anuragbhandari-eng/Gripper_V2/docs/offset_pad_sets_concept_v4.png

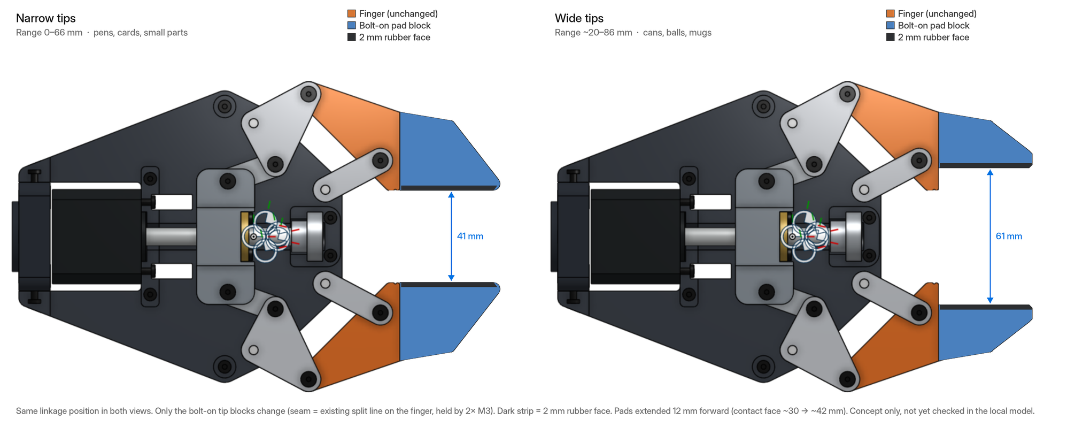
docs/offset_pad_sets_concept_v4.png
