anuragbhandari-eng/Gripper_V2/gripper_fabrication_rev7/BOM.csv

ID | Item | Qty | Note
PRINT | Base x1 (ABS) | 1 | bottom face on bed; 4 walls, 30% gyroid; orientation flat; 107.17 cm3
PRINT | Cover x1 (ABS) | 1 | flat top face on bed; orientation flip_x; 90.33 cm3
PRINT | Adapter ISO9409-50 x1 (ABS) | 1 | gripper-side face on bed, spigot up; orientation front_down; 37.95 cm3
PRINT | Carriage x1 (ABS) | 1 | rear face on bed, nut recess up; no supports; 100% infill around inserts and nut-screw pilots; orientation rear_down; 20.16 cm3
PRINT | BellCrank Lower U x1 (ABS) | 1 | spacer boss up; orientation flat; 5.52 cm3
PRINT | BellCrank Lower L x1 (ABS) | 1 | mirror of BellCrank Lower U (other side); orientation flat; 5.52 cm3
PRINT | BellCrank Upper U+L x2 (ABS) | 2 | same part both sides (flip one); orientation flat; 3.07 cm3
PRINT | FrontCrank Lower U+L x2 (ABS) | 2 | spacer boss up; orientation flat; 2.78 cm3
PRINT | FrontCrank Upper U+L x2 (ABS) | 2 | ; orientation flat; 1.43 cm3
PRINT | ConRod U+L x2 (ABS) | 2 | ; orientation flat; 2.41 cm3
PRINT | Finger U x1 (ABS) | 1 | tongue forward; M layer only since rev 7; orientation flat; 10.19 cm3
PRINT | Finger L x1 (ABS) | 1 | mirror of Finger U; orientation flat; 10.19 cm3
PRINT | Fit test gripper x1 (ABS) | 1 | print FIRST (rev 7 fits): tongue stub + tip-block pocket stub (install the 2 inserts, then test the slide fit and the M3x10 screws), AS5600 slot (1.6 mm board), M6 nut pocket, 2020 column socket, magnet puck (try it in a 608); not part of the gripper; orientation flat; 23.47 cm3
PRINT | Fit test pad x1 (TPU) | 1 | print FIRST in TPU 95A: pad stub with the snap barb, for the pocket stub groove (it should snap in and not pull out by hand); orientation face_down; 0.71 cm3
PRINT | Tip block U narrow x1 (ABS) | 1 | narrow set; floor down, tongue pocket opens upward; orientation flat; 16.1 cm3
PRINT | Tip block L narrow x1 (ABS) | 1 | mirror of Tip block U narrow; orientation flat; 16.1 cm3
PRINT | Tip block U wide x1 (ABS) | 1 | wide set; floor down, tongue pocket opens upward; orientation flat; 10.13 cm3
PRINT | Tip block L wide x1 (ABS) | 1 | mirror of Tip block U wide; orientation flat; 10.13 cm3
PRINT | Pad TPU U+L x4 (TPU) | 4 | TPU 95A, contact face on bed; 2 per tip set (same pad fits both); orientation side_py_down; 1.71 cm3
PRINT | Encoder magnet puck x1 (ABS) | 1 | magnet pocket up; glue to the screw end; orientation rear_down; 0.07 cm3
PRINT | Stand head bracket x1 (ABS) | 1 | bench stand; back face on bed, nut pockets and column hole open upward; orientation rear_down; 137.36 cm3
PRINT | Stand base x1 (ABS) | 1 | bench stand; table face on bed, column socket up; orientation front_down; 257.41 cm3
PRINT | Stand desk clamp U x1 (ABS) | 1 | desk clamp; lying on its side, nut slot up, 100% infill at the corners; orientation side_my_down; 52.58 cm3
PRINT | Stand desk clamp L x1 (ABS) | 1 | mirror of Stand desk clamp U; orientation side_py_down; 52.58 cm3
PRINT | Stand clamp pad U+L x2 (TPU) | 2 | desk side down; felt on it is optional; orientation rear_down; 2.54 cm3
PRINT | Controller spacer rear+front U+L x4 (ABS) | 4 | end on bed, 100% infill; 4 mm tall, replaces the brass standoffs (M3 x 10 through board and spacer into the cover insert); orientation flat; 0.06 cm3
PRINT | Electronics cover x1 (ABS) | 1 | top face on bed, no supports; 2 M3 x 8 into the cover-top inserts; orientation flip_x; 16.62 cm3
PRINT | Fit test coupons x1 (ABS) | 1 | Print FIRST: checks pin bores, z-stack gaps, 608 seat and carriage tongue fit on your printer; 16 cm3
P1 | NEMA 17 stepper with integrated Tr8x8 lead screw (4 start, 8 mm lead) and brass flange nut: YEJMKJ N17-Y42-39-SG240, body 42 x 42 x 38.7 mm, 240 mm screw, 0.44 N.m, 1.7 A, 2.2 ohm, 3.1 mH, rotor about 65 g.cm2 (Amazon US ASIN B0FHHWXJLV, in the cart) | 1 | Cut the screw so it sticks out 71.0 mm past the D22 pilot face (73.0 mm from the mounting face), -0.5/+0: never long, the encoder puck fills the last 3 mm of the 608 bore; chamfer the end. The body is 1.3 mm shorter than modelled (40 mm), so the gap to the adapter is 2.3 mm: no change needed. If the flange nut is missing, buy a Tr8x8 brass flange nut (22 mm flange, 4 holes)
P2 | Tr8x8 brass flange nut (flange D22 x 3.5, body D10.2, 4x D3.5 on D16; check on the listing) - usually supplied with P1 | 1
P3 | 608ZZ ball bearing 8 x 22 x 7 | 1 | Screw tip support; carries the grip thrust into the block front lip
P12 | Shaft lock collar, 8 mm bore, OD <= 14 mm, width <= 7 mm, with set screw (e.g. OpenBuilds T8 lock collar) | 1 | Behind the 608, against its inner ring: takes the screw reaction when gripping
P4 | Dowel pin D4 x 40, hardened bearing steel, +/-0.02 mm, cut to 38.5 mm (Amazon US has no hardened 4 x 36) | 4 | Fixed pivots O1, O2: cut each pin to 38.5 mm with an abrasive cut-off disc (deburr the cut end), press it up through the base from underneath until flush with the underside; its top then sits flush with the cover top (9 mm of press fit)
P27 | Sintered bronze sleeve bushing 4 x 6 x 6 mm + slow-cure epoxy + paste wax | 4 | Bonded into the cover round the dowel tops (rev 7.1)
P28 | Locating pin D3 x 16: an M3 x 16 button screw from the kit with the head cut off (cost cut; replaces an ISO 8734 3 x 16 dowel) | 2 | Register the base and cover halves of the bearing block: screw into the base half, cover half slides on
P5 | Shoulder screw, 4 mm shoulder x 12 mm, M3 thread <= 6 mm, head <= D7.5 x 3.5 (bought: MECCANIXITY 304 stainless, M3 x 6 thread, head D7 x 3) | 8 | Moving pivots F1, F2, D, C x2 sides
P6 | M3 heat-set insert, M3 x 5.7, for D4.0 hole | 28 | Buy 30 (rev 7: +4 in the finger tongues, +4 in the cover top for the controller; rev 7.2: +2 for the electronics cover)
P7 | M3 x 8 button head screw ISO 7380 | 14 | 4 motor (3.5 mm into the motor), 2 cover-to-post, 2 nut flange (self-tap into D2.5 pilots), 4 side walls to adapter, 2 electronics cover
P8 | M3 x 20 button head screw ISO 7380 | 4 | Cover to motor wall (2) and bearing block (2)
P13 | M3 x 10 button head screw ISO 7380 | 8 | Tip blocks to the finger tongues, from below (2 per side); controller board through its spacers into the cover inserts (4)
P9 | M6 x 12 socket head cap screw ISO 4762 (6 mm into the robot flange; check its thread depth) | 4 | Adapter to ISO 9409-1-50-4-M6 flange
P10 | Grease: PTFE/lithium for lead screw and pivots (ask the fablab; any light grease works) | 1
P11 | TMC2209 stepper driver module, StepStick size (e.g. BIGTREETECH TMC2209), UART + DIAG | 1 | Current limit 0.70 A RMS (section 4); plugged into female headers on the protoboard so it can be swapped
P14 | Raspberry Pi Pico (or Pico H with headers) | 1 | USB serial to ROS 2; on the protoboard
P15 | AS5600 magnetic encoder module (about 23 x 23 mm) + 6 x 2.5 mm diametric magnet | 1 | Solder 4 wires (VCC, GND, SDA, SCL) to the pad row, no header; pad row up
P16 | Double-sided protoboard 50 x 70 mm, cut to 48 x 60 mm | 1 | Score and snap (or saw) it to 48 x 60, then drill 4 corner holes to 3.2 mm on a 42 x 54 mm pattern
P17 | Printed spacer Controller spacer rear+front U+L x4 (D5.5 x 4, room for the solder joints under the board) + M3 x 10 button screw from the kit | 4 | Screw through the board and spacer into the cover-top insert
P18 | L7805 5 V regulator + 1N5817 Schottky diode (any 1 A diode works) + 2 x 100 nF (ask the fablab first) | 1 | 9 V line -> 7805 -> diode -> Pico VSYS: one cable from the power bank runs everything, the laptop is optional and can be plugged in at the same time
P19 | USB-C PD power bank, about 10,000 mAh, 20 W, any brand that says PD (all of them offer 9 V); use one you already own | 1 | Battery and charger in one: recharge it from any USB charger. Sits on the desk next to the stand (the modelled pack on the column is a placeholder)
P20 | USB-C PD trigger (decoy) board, set to 9 V; check its output with a multimeter before connecting the driver | 1 | USB-C cable from the power bank, or from any USB-C laptop or phone charger of 18 W or more; + and - go to TMC2209 VM, the divider and the 7805
P21 | Not needed with the power bank: LiPo, balance charger, XT30 pigtail, fuse holder (the bank has its own protection) | 0
P22 | Resistors 100 k + 27 k (battery divider into Pico ADC0; 22 k also works, change the ratio in firmware) + 10 k (EN pull-up), 100 uF 35 V capacitor at TMC2209 VM; 100 nF at ADC0 optional (ask the fablab first) | 1
P23 | 2020 aluminium extrusion, 400 mm (V-slot or T-slot) | 1 | Bench stand column
P24 | M5 T-nut for 2020 (sliding or drop-in) + M5 x 12 screw, 4 + 1 for the column end; 4 bench screws not needed with the desk clamps | 1 | Head bracket to column (2), base socket to column (2), base to column end (1: tap the end M5, 4 mm of thread is enough, or skip it). Sliding T-nuts go in from the column ends before the bracket and base
P29 | M8 x 40 star knob screw (male thread) + M8 hex nut (nut from the fablab or a hardware store) | 2 | Desk clamps (nut drops into the slot in each clamp)
P30 | Self-adhesive felt pads, about 25 mm (optional, not bought) | 4 | On the clamp pads and under the base front corners, to protect the desk
P25 | M6 x 20 socket head cap screw ISO 4762 + M6 hex nut | 4 | Adapter to the stand head bracket (nuts drop into the bracket from the back)
P26 | TPU 95A filament | 1 | Contact pads (Pad TPU U+L x4, 4 pcs)
