anuragbhandari-eng/Gripper_V2/ros2_ws/src/lead_screw_gripper_description/onshape/assets/merged/finger_L_link_visual.stl

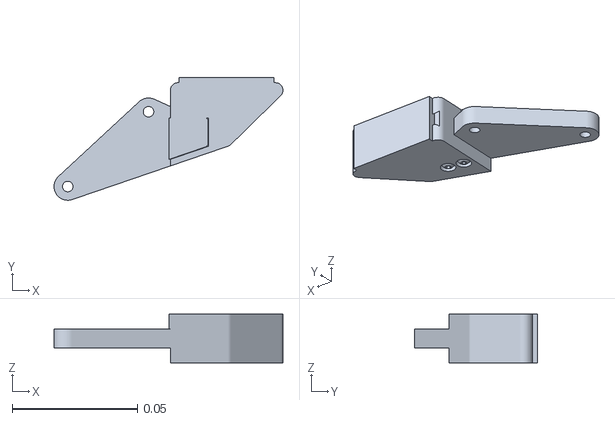
[picture p7: CAD file, 2026-11-13]
ros2_ws/src/lead_screw_gripper_description/onshape/assets/merged/finger_L_link_visual.stl
0.0915 x 0.049 x 0.0195
