anuragbhandari-eng/Gripper_V2/ros2_ws/src/lead_screw_gripper_description/onshape_render/assets/pico_ref_board_step__none.stl

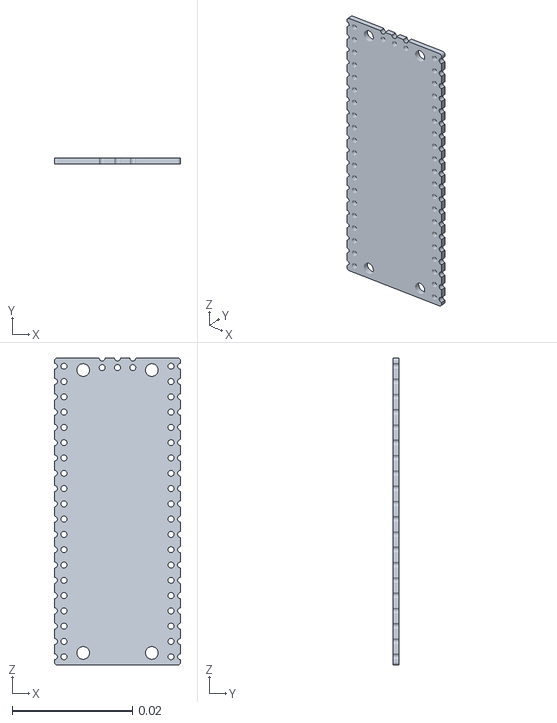
[picture p8: CAD file, 2026-11-13]
ros2_ws/src/lead_screw_gripper_description/onshape_render/assets/pico_ref_board_step__none.stl
0.021 x 0.001 x 0.051
