anuragbhandari-eng/Gripper_V2/ros2_ws/src/lead_screw_gripper_description/meshes/visual/base.stl

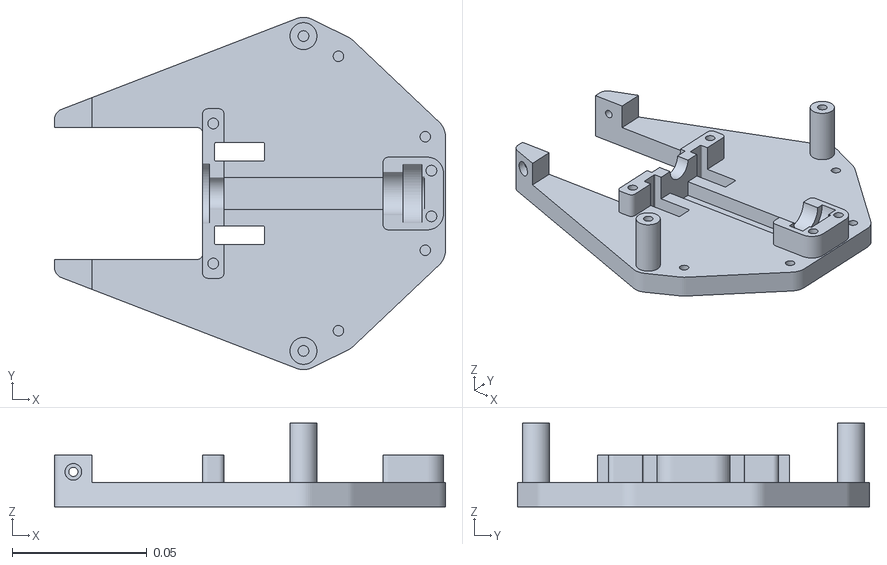
[picture p9: CAD file, 2026-11-13]
ros2_ws/src/lead_screw_gripper_description/meshes/visual/base.stl
0.145 x 0.131 x 0.0311
