anuragbhandari-eng/Gripper_V2/ros2_ws/src/lead_screw_gripper_description/onshape/assets/merged/conrod_U_link_visual.stl

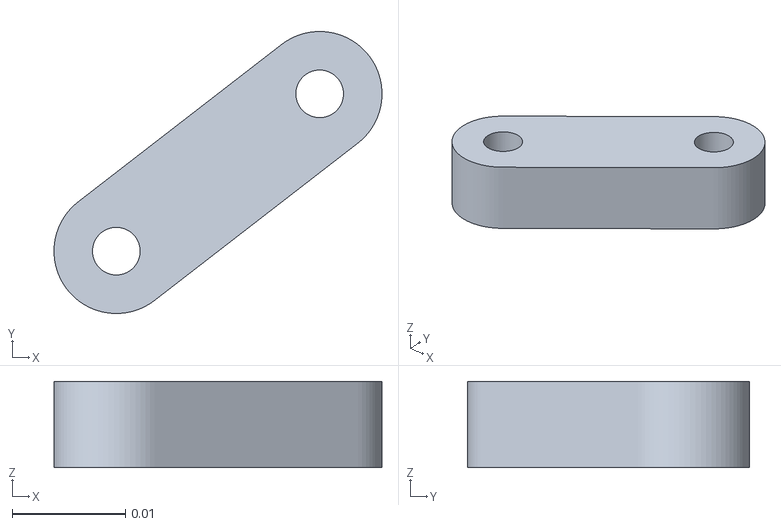
[picture p10: CAD file, 2026-11-13]
ros2_ws/src/lead_screw_gripper_description/onshape/assets/merged/conrod_U_link_visual.stl
0.0289 x 0.0249 x 0.0076
