anuragbhandari-eng/Gripper_V2/ros2_ws/src/lead_screw_gripper_description/onshape_render/assets/cover.stl

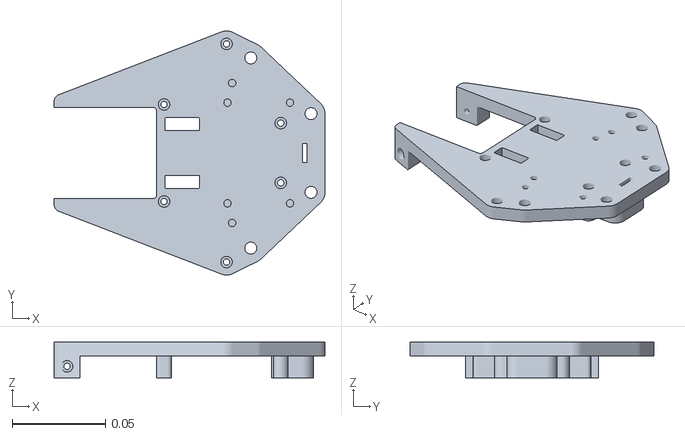
[picture p11: CAD file, 2026-11-13]
ros2_ws/src/lead_screw_gripper_description/onshape_render/assets/cover.stl
0.145 x 0.131 x 0.0192
