anuragbhandari-eng/Gripper_V2/ros2_ws/src/lead_screw_gripper_description/meshes/visual/bell_crank_upper_u.stl

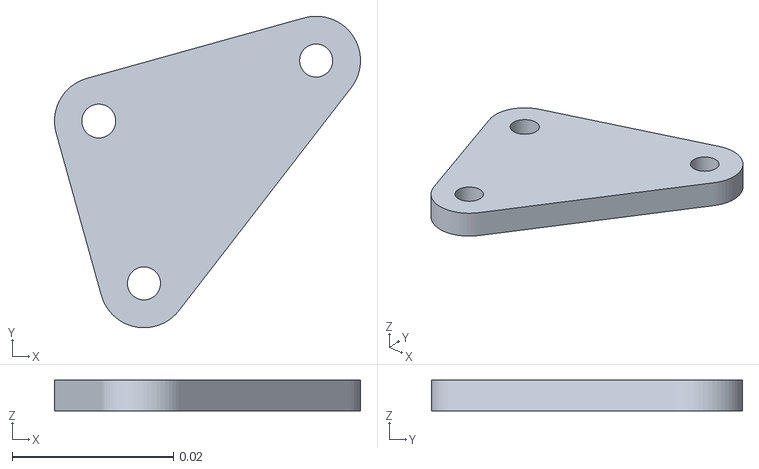
[picture p12: CAD file, 2026-11-13]
ros2_ws/src/lead_screw_gripper_description/meshes/visual/bell_crank_upper_u.stl
0.038 x 0.0386 x 0.0038
