anuragbhandari-eng/Gripper_V2/ros2_ws/src/lead_screw_gripper_description/onshape_render/assets/socket_button_head_screw_m3x0_5_x_20__a36a91f17289e228f9f9bd0e86f10504.stl

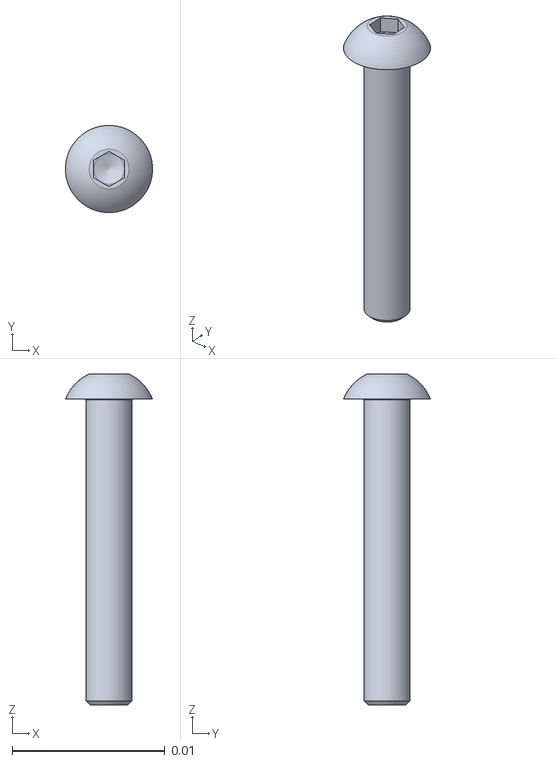
[picture p13: CAD file, 2026-11-13]
ros2_ws/src/lead_screw_gripper_description/onshape_render/assets/socket_button_head_screw_m3x0_5_x_20__a36a91f17289e228f9f9bd0e86f10504.stl
0.0057 x 0.0057 x 0.0216
