anuragbhandari-eng/Gripper_V2/ros2_ws/src/lead_screw_gripper_description/onshape/assets/merged/carriage_link_visual.stl

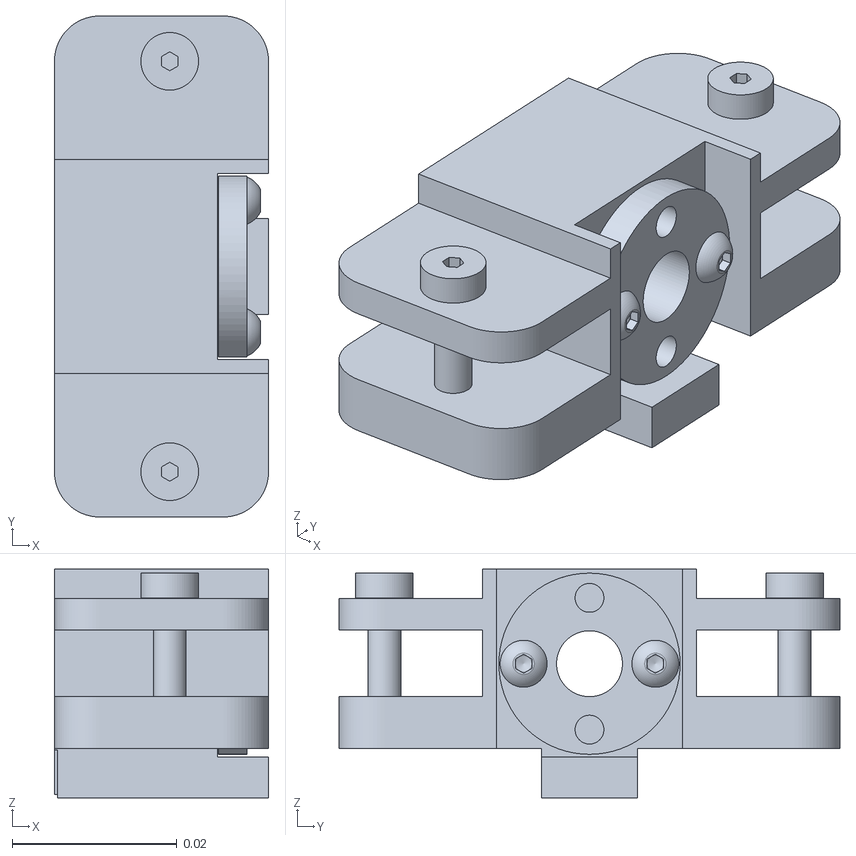
[picture p14: CAD file, 2026-11-13]
ros2_ws/src/lead_screw_gripper_description/onshape/assets/merged/carriage_link_visual.stl
0.026 x 0.0608 x 0.0278
