anuragbhandari-eng/Gripper_V2/ros2_ws/src/lead_screw_gripper_description/onshape_render/assets/bushing_4x6x6_o1_l.stl

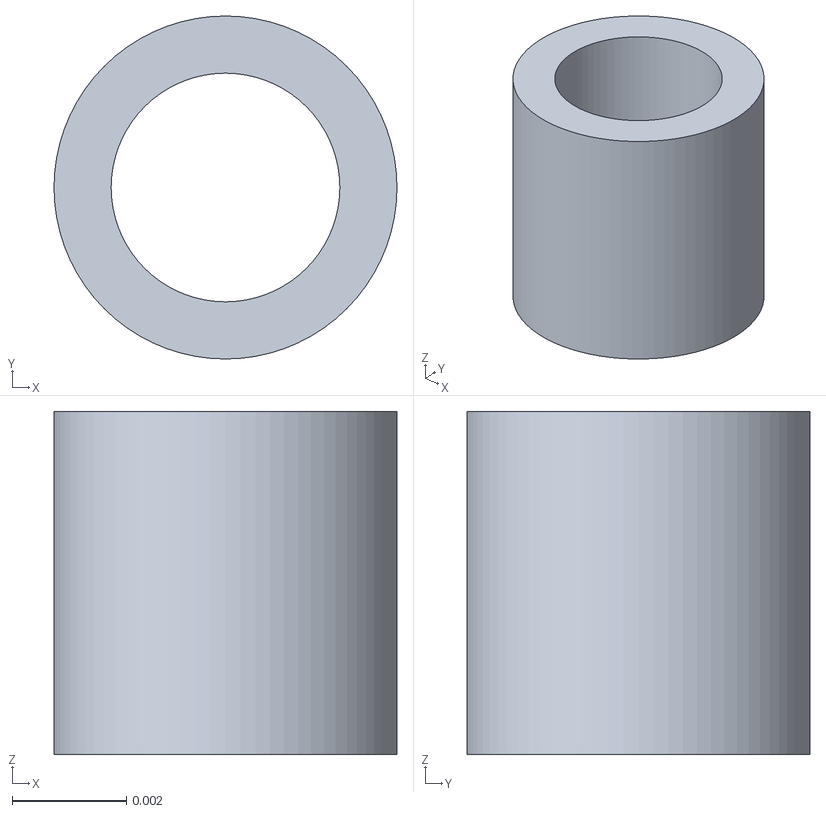
[picture p15: CAD file, 2026-11-13]
ros2_ws/src/lead_screw_gripper_description/onshape_render/assets/bushing_4x6x6_o1_l.stl
0.006 x 0.006 x 0.006
