anuragbhandari-eng/Gripper_V2/ros2_ws/src/lead_screw_gripper_description/onshape/assets/merged/bell_crank_U_link_visual.stl

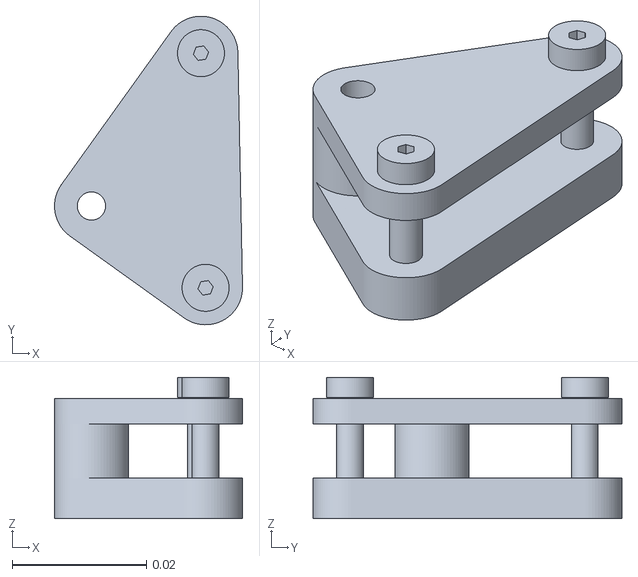
[picture p16: CAD file, 2026-11-13]
ros2_ws/src/lead_screw_gripper_description/onshape/assets/merged/bell_crank_U_link_visual.stl
0.028 x 0.0459 x 0.021
