anuragbhandari-eng/Gripper_V2/ros2_ws/src/lead_screw_gripper_description/onshape_render/assets/pico_bourns_step__none.stl

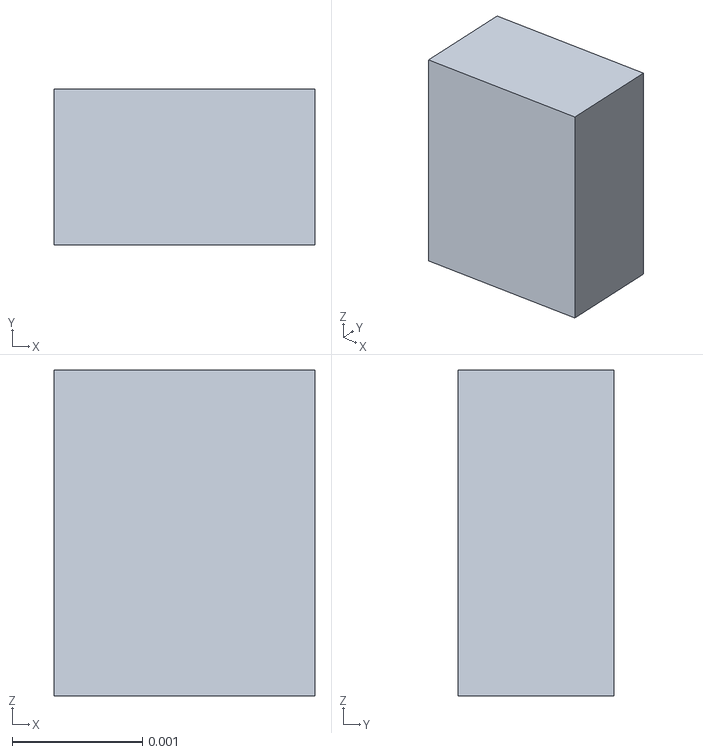
[picture p17: CAD file, 2026-11-13]
ros2_ws/src/lead_screw_gripper_description/onshape_render/assets/pico_bourns_step__none.stl
0.002 x 0.0012 x 0.0025
