anuragbhandari-eng/Gripper_V2/ros2_ws/src/lead_screw_gripper_description/onshape/assets/merged/front_crank_L_link_visual.stl

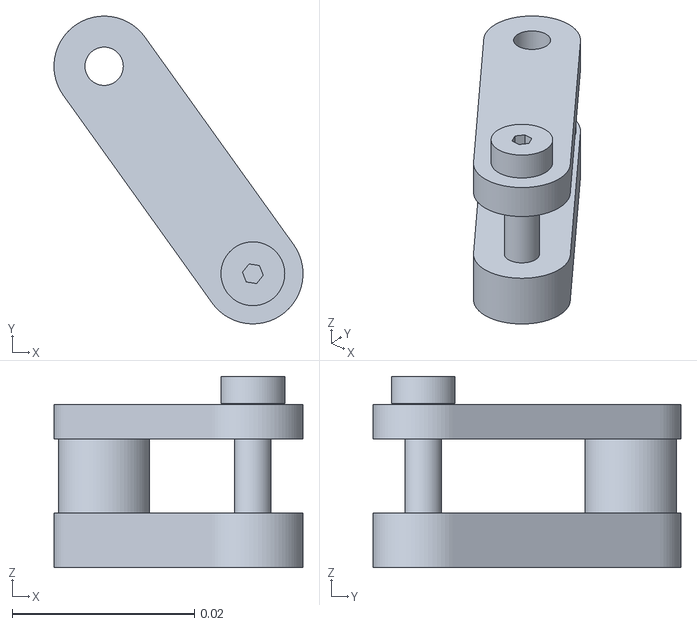
[picture p18: CAD file, 2026-11-13]
ros2_ws/src/lead_screw_gripper_description/onshape/assets/merged/front_crank_L_link_visual.stl
0.0273 x 0.0338 x 0.021
