anuragbhandari-eng/Gripper_V2/ros2_ws/src/lead_screw_gripper_description/onshape_render/assets/locating_pin_m3x16_headless_u.stl

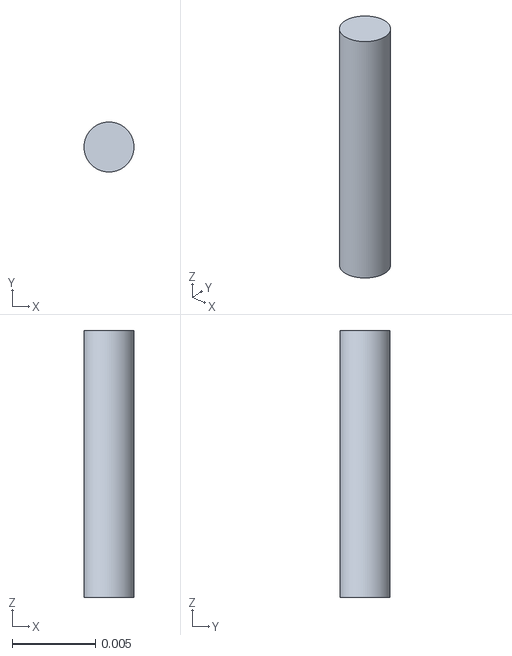
[picture p19: CAD file, 2026-11-13]
ros2_ws/src/lead_screw_gripper_description/onshape_render/assets/locating_pin_m3x16_headless_u.stl
0.003 x 0.003 x 0.016
