anuragbhandari-eng/Gripper_V2/ros2_ws/src/lead_screw_gripper_description/onshape_render/assets/controller_spacer_front_l.stl

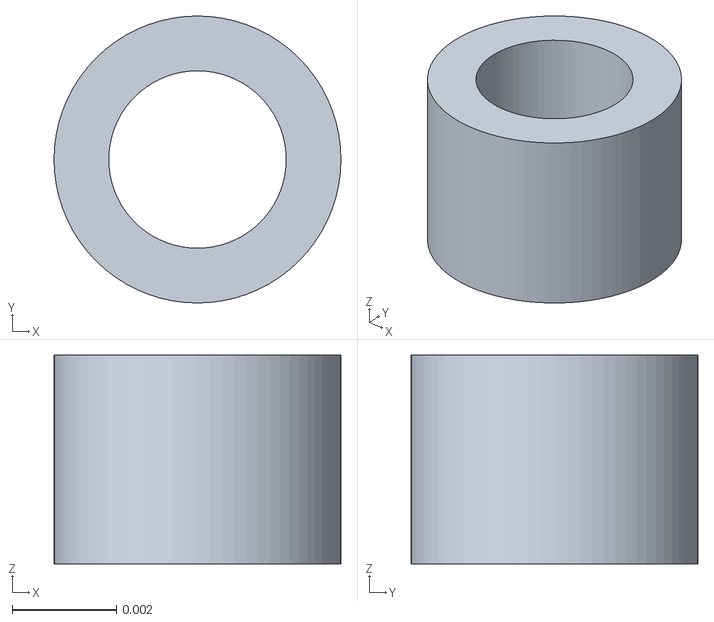
[picture p20: CAD file, 2026-11-13]
ros2_ws/src/lead_screw_gripper_description/onshape_render/assets/controller_spacer_front_l.stl
0.0055 x 0.0055 x 0.004
