anuragbhandari-eng/Gripper_V2/(list of files, cad)

Other CAD files:
ros2_ws/src/lead_screw_gripper_description/onshape/assets/merged/conrod_L_link_visual.stl
ros2_ws/src/lead_screw_gripper_description/onshape/assets/merged/front_crank_U_link_visual.stl
ros2_ws/src/lead_screw_gripper_description/onshape/assets/merged/finger_U_link_visual.stl
ros2_ws/src/lead_screw_gripper_description/onshape/assets/merged/base_link_visual.stl
ros2_ws/src/lead_screw_gripper_description/onshape/assets/merged/bell_crank_L_link_visual.stl
ros2_ws/src/lead_screw_gripper_description/onshape_render/assets/608zz_bearing.stl
ros2_ws/src/lead_screw_gripper_description/onshape_render/assets/adapter_iso9409_50.stl
ros2_ws/src/lead_screw_gripper_description/onshape_render/assets/as5600_encoder_board.stl
ros2_ws/src/lead_screw_gripper_description/onshape_render/assets/base.stl
ros2_ws/src/lead_screw_gripper_description/onshape_render/assets/bellcrank_lower_l.stl
ros2_ws/src/lead_screw_gripper_description/onshape_render/assets/bellcrank_lower_u.stl
ros2_ws/src/lead_screw_gripper_description/onshape_render/assets/bellcrank_upper_l.stl
ros2_ws/src/lead_screw_gripper_description/onshape_render/assets/bellcrank_upper_u.stl
ros2_ws/src/lead_screw_gripper_description/onshape_render/assets/bushing_4x6x6_o1_u.stl
ros2_ws/src/lead_screw_gripper_description/onshape_render/assets/bushing_4x6x6_o2_l.stl
ros2_ws/src/lead_screw_gripper_description/onshape_render/assets/bushing_4x6x6_o2_u.stl
ros2_ws/src/lead_screw_gripper_description/onshape_render/assets/capacitor_100uf_35v.stl
ros2_ws/src/lead_screw_gripper_description/onshape_render/assets/carriage.stl
ros2_ws/src/lead_screw_gripper_description/onshape_render/assets/conrod_l.stl
ros2_ws/src/lead_screw_gripper_description/onshape_render/assets/conrod_u.stl
ros2_ws/src/lead_screw_gripper_description/onshape_render/assets/controller_spacer_front_u.stl
ros2_ws/src/lead_screw_gripper_description/onshape_render/assets/controller_spacer_rear_l.stl
ros2_ws/src/lead_screw_gripper_description/onshape_render/assets/controller_spacer_rear_u.stl
ros2_ws/src/lead_screw_gripper_description/onshape_render/assets/dowel_4x38_5__40_cut__o1_l.stl
ros2_ws/src/lead_screw_gripper_description/onshape_render/assets/dowel_4x38_5__40_cut__o1_u.stl
ros2_ws/src/lead_screw_gripper_description/onshape_render/assets/dowel_4x38_5__40_cut__o2_l.stl
ros2_ws/src/lead_screw_gripper_description/onshape_render/assets/dowel_4x38_5__40_cut__o2_u.stl
ros2_ws/src/lead_screw_gripper_description/onshape_render/assets/electronics_cover.stl
ros2_ws/src/lead_screw_gripper_description/onshape_render/assets/encoder_magnet_puck.stl
ros2_ws/src/lead_screw_gripper_description/onshape_render/assets/finger_l.stl
ros2_ws/src/lead_screw_gripper_description/onshape_render/assets/finger_u.stl
ros2_ws/src/lead_screw_gripper_description/onshape_render/assets/frontcrank_lower_l.stl
ros2_ws/src/lead_screw_gripper_description/onshape_render/assets/frontcrank_lower_u.stl
ros2_ws/src/lead_screw_gripper_description/onshape_render/assets/frontcrank_upper_l.stl
ros2_ws/src/lead_screw_gripper_description/onshape_render/assets/frontcrank_upper_u.stl
ros2_ws/src/lead_screw_gripper_description/onshape_render/assets/header_sockets_driver_2x8.stl
ros2_ws/src/lead_screw_gripper_description/onshape_render/assets/header_sockets_driver_2x8__2.stl
ros2_ws/src/lead_screw_gripper_description/onshape_render/assets/header_sockets_pico_2x20.stl
ros2_ws/src/lead_screw_gripper_description/onshape_render/assets/header_sockets_pico_2x20__2.stl
ros2_ws/src/lead_screw_gripper_description/onshape_render/assets/locating_pin_m3x16_headless_l.stl
ros2_ws/src/lead_screw_gripper_description/onshape_render/assets/lock_collar_8x14x7__thrust.stl
ros2_ws/src/lead_screw_gripper_description/onshape_render/assets/magnet_6x2_5_diametric.stl
ros2_ws/src/lead_screw_gripper_description/onshape_render/assets/nema17_stepper_yejmkj_42x38_7.stl
ros2_ws/src/lead_screw_gripper_description/onshape_render/assets/pad_tpu_l.stl
ros2_ws/src/lead_screw_gripper_description/onshape_render/assets/pad_tpu_u.stl
ros2_ws/src/lead_screw_gripper_description/onshape_render/assets/pico_ael_step__none.stl
ros2_ws/src/lead_screw_gripper_description/onshape_render/assets/pico_diodes_step__none.stl
ros2_ws/src/lead_screw_gripper_description/onshape_render/assets/pico_murata_step__none.stl
ros2_ws/src/lead_screw_gripper_description/onshape_render/assets/pico_murata_step__none_1.stl
ros2_ws/src/lead_screw_gripper_description/onshape_render/assets/pico_ref_led_step__none.stl
ros2_ws/src/lead_screw_gripper_description/onshape_render/assets/pico_ref_microcontroller_step__none.stl
ros2_ws/src/lead_screw_gripper_description/onshape_render/assets/pico_ref_onsemi_step__none.stl
ros2_ws/src/lead_screw_gripper_description/onshape_render/assets/pico_ref_switch_step__none.stl
ros2_ws/src/lead_screw_gripper_description/onshape_render/assets/pico_ref_usb_step__none.stl
ros2_ws/src/lead_screw_gripper_description/onshape_render/assets/pico_ref_usb_step__none__2.stl
ros2_ws/src/lead_screw_gripper_description/onshape_render/assets/pico_ref_usb_step__none__3.stl
ros2_ws/src/lead_screw_gripper_description/onshape_render/assets/pico_ref_usb_step__none__4.stl
ros2_ws/src/lead_screw_gripper_description/onshape_render/assets/pico_ref_usb_step__none__5.stl
ros2_ws/src/lead_screw_gripper_description/onshape_render/assets/pico_richtek_step__none.stl
ros2_ws/src/lead_screw_gripper_description/onshape_render/assets/pico_winbond_step__none.stl
ros2_ws/src/lead_screw_gripper_description/onshape_render/assets/protoboard_50x70.stl
ros2_ws/src/lead_screw_gripper_description/onshape_render/assets/regulator_7805_to_220.stl
ros2_ws/src/lead_screw_gripper_description/onshape_render/assets/shoulder_screw_4x12_m3_c_l.stl
ros2_ws/src/lead_screw_gripper_description/onshape_render/assets/shoulder_screw_4x12_m3_c_u.stl
ros2_ws/src/lead_screw_gripper_description/onshape_render/assets/shoulder_screw_4x12_m3_d_l.stl
ros2_ws/src/lead_screw_gripper_description/onshape_render/assets/shoulder_screw_4x12_m3_d_u.stl
ros2_ws/src/lead_screw_gripper_description/onshape_render/assets/shoulder_screw_4x12_m3_f1_l.stl
ros2_ws/src/lead_screw_gripper_description/onshape_render/assets/shoulder_screw_4x12_m3_f1_u.stl
ros2_ws/src/lead_screw_gripper_description/onshape_render/assets/shoulder_screw_4x12_m3_f2_l.stl
ros2_ws/src/lead_screw_gripper_description/onshape_render/assets/shoulder_screw_4x12_m3_f2_u.stl
ros2_ws/src/lead_screw_gripper_description/onshape_render/assets/socket_button_head_screw_m3x0_5_x_10__ab5dc1006d13f2491c23b78383e7390f.stl
ros2_ws/src/lead_screw_gripper_description/onshape_render/assets/socket_button_head_screw_m3x0_5_x_8__06a2044c27756322d8b45e7715e9afaa.stl
ros2_ws/src/lead_screw_gripper_description/onshape_render/assets/tip_block_l.stl
ros2_ws/src/lead_screw_gripper_description/onshape_render/assets/tip_block_u.stl
ros2_ws/src/lead_screw_gripper_description/onshape_render/assets/tmc2209_driver.stl
ros2_ws/src/lead_screw_gripper_description/onshape_render/assets/tr8_brass_flange_nut.stl
ros2_ws/src/lead_screw_gripper_description/onshape_render/assets/tr8x8_lead_screw__cut_73_0mm.stl
ros2_ws/src/lead_screw_gripper_description/onshape_render/assets/usb_c_pd_trigger_9v.stl
