anuragbhandari-eng/Gripper_V2/docs/BUILD_AND_TEST_GUIDE.html

Gripper V2 build

0 / 0

REV 7.2b · BUILD AND TEST GUIDE

# From a box of parts to a working gripper

Nine parts, A to I. Every step ends with a check, so a problem shows up where it starts. Tick the boxes as you go: this page remembers them on this device.

If a check fails, stop. Note what the Thonny shell printed, or what you see, and find the cause before going on.

blue in a picture = parts added in that step pale = already fitted

The finished gripper: dark base and cover, orange fingers with black grip pads, and the controller under its cover on top.

What you are building. Controller on top, jaws at the front.

## Five safety rules

1. Never plug or unplug the motor or the driver while the power is on. That kills the TMC2209 instantly. Unplug the 9 V and the laptop USB first.
2. The driver current is a safety setting. Set VREF to 0.99 V before the motor is ever connected, and never higher. At full current the motor can push about 259 N, far more than the printed parts are designed for.
3. Use 9 V only. Set the trigger board to 9 V and measure it before it touches the board.
4. Tighten every M3 screw only until snug, with the short arm of the key (0.15 N·m). More than that crushes the ABS.
5. Keep fingers out of the jaws while it's powered. With the driver off the jaws go limp and can be pushed by hand. That is normal: the screw back-drives.

## What you need besides the parts

### Tools

- Soldering iron, with a spare or conical tip for heat-set inserts
- Multimeter and calipers
- Metric hex keys: 2 mm for every M3 screw, 5 mm for M6, 3 or 4 mm for the M5 screws (depends on the kit), plus a 2 mm ball-end
- 4.0 mm drill bit (turned by hand) and a 3.2 mm drill bit
- Dremel with an abrasive cut-off wheel. The dowels are hardened; a hacksaw won't cut them
- Hacksaw for the lead screw, small file
- Bench vise with soft jaws, flush cutters, pliers
- Small plastic or ceramic screwdriver for the driver's pot
- Safety glasses for cutting and pressing steel
- Optional: M5 tap

### Consumables

- Solder, heat-shrink, tape
- Hookup wire: thin (24 AWG) for signals, thicker (20 AWG) for 9 V and the motor
- 30-minute epoxy and CA (super) glue
- Light grease, and a little wax or grease as a release agent
- Zip ties
- 2 M8 hex nuts
- USB-C cable from the laptop to the Pico
- USB-C cable from the power bank to the trigger board
- 20 W USB-C PD power bank

A

## When the parts arrive

A1

### Check the parts

DONE

Measure each part with calipers before anything else. If one is off, update that part in design.py.

Part | It should measure
Motor | Body 42 × 42 mm and at most 40 mm long. Pilot Ø22 × 2. M3 holes on a 31 mm square. Screw usable length at least 73 mm
Brass nut (on the motor screw) | Flange Ø22 × 3.5, body Ø10.2, 4 holes. If it's missing, buy a Tr8x8 flange nut
AS5600 board | At most 23 × 23 mm with the chip centred. Parts on the chip side within a 19.6 mm square
Shoulder screws | Shoulder Ø4 × 12, thread M3 at most 6 mm long, head at most Ø7.5 × 3.5
Dowels | Ø4.0 × 40. A bronze bushing slides onto a dowel with no play
Lock collar | Bore 8 mm, OD at most 14 mm, width at most 7 mm
608ZZ bearing | Spins freely. If not, use another from the pack

Check All parts measured and within size

A2

### Print the fit tests first

DONE

Three small prints check every fit that depends on your printer. Print them in ABS on the printer you'll use for the real parts. They take a few hours and can save a full reprint.

Fit test gripper x1.stl · ABS · fit its 2 inserts first (see D2) The tongue stub slides into the tip-block pocket stub with no play and no forcing The 2 M3×10 screws go in and hold An AS5600 board slides into the slot An M6 nut drops into its pocket The 2020 extrusion fits its socket The magnet fits its puck, and the puck fits inside a 608

Fit test pad x1.stl · TPU It snaps into the pocket-stub groove and doesn't pull out by hand

Fit test coupons x1.stl · ABS A dowel presses into the Ø3.9 hole, is snug in Ø4.1 and turns freely in Ø4.2 The stacked test plates move freely in their 0.2 / 0.3 mm gaps A 608 sits in the cradle against the front lip, no rattle and no forcing The 11.6 mm tongue slides along the 12.0 mm channel

If a fit is off, change that one clearance in the design and re-export the parts before you print them.

A3

### Magnet test

DONE

Do this before printing the base and cover. The magnet sits inside the steel 608, which can weaken its field. This 5-minute test confirms the encoder still reads well there.

1. Install MicroPython on the Pico (step C1).
2. Glue the magnet into the puck from the fit test, and push the puck into a 608.
3. Wire the AS5600 to the Pico: VCC → 3V3 (pin 36), GND → GND (pin 38), SDA → GP0 (pin 1), SCL → GP1 (pin 2), DIR → GND.
4. Hold the board flat in front of the magnet, chip centred on it and about 0.8 mm away. The test only means something in that position.
5. Open as5600_bench_test.py in Thonny, run it, and turn the 608's inner ring slowly by hand.

Check It prints "magnet: OK" the whole time AGC sits roughly between 30 and 100 The angle runs smoothly through 0–360° once per turn

Stop if it says "too weak" or AGC sits at 128. The magnet would then have to move in front of the bearing, which needs a longer block.

B

## Print everything

B1

### Settings and order

DONE

The files are in gripper_fabrication_rev7/stl/. Each file name ends with how many to print (x1, x2, x4). Orientations are in the design report, section 6.

Setting | Value
Material | ABS in an enclosed printer, part fan low or off
Layers and walls | 0.2 mm layers, 4 perimeters
Infill | 30–40% gyroid, 100% around insert holes
Brim and supports | Brim on the base, cover and all stand parts. No supports anywhere

1. Base and cover. The largest, and the most likely to warp.
2. Small parts: carriage, adapter, cranks, conrods and fingers.
3. Both tip sets, the encoder puck, the 4 controller spacers and the electronics cover (top face on the bed).
4. In TPU: the 4 jaw pads and the 2 stand clamp pads.
5. Stand parts: base, head bracket and 2 desk clamps. ABS is preferred; PLA is fine if the big base warps.

Check Flatness: the base, cover and stand base sit on glass without rocking. Reprint any that rock Quantities match the x2 and x4 in the file names

C

## Electronics on the bench

Do this while the parts print.

C1

### Install MicroPython and Thonny

DONE

1. Install Thonny (https://thonny.org) on your laptop.
2. Download the latest MicroPython UF2 for the Raspberry Pi Pico (RP2040) from micropython.org.
3. Hold the Pico's BOOTSEL button while plugging it into the laptop. Drag the UF2 onto the RPI-RP2 drive that appears.
4. In Thonny: Tools → Options → Interpreter → "MicroPython (Raspberry Pi Pico)".
5. Copy bench.py to the Pico: open it in Thonny, then File → Save as → Raspberry Pi Pico → bench.py.

Check Typing import bench in the Thonny shell prints the list of tests. Errors about missing hardware are fine for now

C2

### Solder the controller board

DONE

1. Cut the 50 × 70 mm protoboard down to 48 × 60 mm: score along a row of holes and snap it, or saw it.
2. Drill 4 mounting holes to 3.2 mm, in two rows. Each row is 3 mm in from a short (48 mm) edge, so the rows are 54 mm apart. In each row:
  - one hole is 3 mm from the long edge on the driver side;
  - the other is 36.5 mm from that same edge, on the Pico's centreline between its two socket rows.
3. Cut the 1 × 40 socket strips into two 1 × 20 rows for the Pico and two 1 × 8 rows for the driver. Check which way round the driver goes (EN pin to EN) before soldering its sockets.
4. Lay the parts out as in the picture, so the cover fits:
  - Pico sockets along one long edge, USB end at a short edge.
  - Driver sockets beside the Pico, toward the other short edge.
  - Trigger board taped flat at the USB end next to the Pico, its socket just over the edge.
  - 7805 lying flat beside it, legs bent down 90°, tab 6–7 mm in from the edge and clear of the corner screw.
  - 100 µF capacitor standing between the 7805 and the driver.
5. Wire it to the table below. Keep the 9 V wires short and thick.

The controller board with its Pico, driver, regulator, capacitor and USB-C trigger board, lifted above the gripper's cover with four spacers and screws.

The finished board and where it will sit (fitted in Part E).

From | To | Notes
Trigger board + | 9 V line: driver VM, 7805 IN, 100 k (divider top), 100 µF + | Thick wire
Trigger board − | Common GND | Thick wire
100 µF 35 V | Across VM and GND, right next to the driver | Mind the polarity (stripe = −)
7805 | IN = 9 V, GND, OUT → 1N5817 anode | 100 nF from IN to GND and from OUT to GND. Pins left to right, label facing you: IN, GND, OUT
1N5817 | Cathode (the band) → Pico VSYS (pin 39) | Lets USB and the 9 V be connected together
Divider | 100 k from 9 V to Pico GP26 (pin 31); 27 k from GP26 to GND | 9 V reads 1.91 V. Optional 100 nF across the 27 k
All grounds | Pico GND (pin 38 and others), both driver GND pins, AS5600 GND | Every ground joins the same line
Pico 3V3 (pin 36) | Driver VIO, AS5600 VCC
Pico GP2 (pin 4) | Driver STEP
Pico GP3 (pin 5) | Driver DIR
Pico GP4 (pin 6) | Driver EN | Plus 10 k from EN to 3V3: keeps the driver off while the Pico starts
Pico GP8 (pin 11) | 1 k resistor → driver UART/PDN pin
Pico GP9 (pin 12) | Driver UART/PDN pin, directly | Same pin as the 1 k
Pico GP5 (pin 7) | Driver DIAG | Optional (stall backup)
Pico GP0 (pin 1), GP1 (pin 2) | AS5600 SDA, SCL | 4-wire lead; also AS5600 DIR → GND
Driver coil pins | Motor coils (step C6) | Marked 1A/1B/2A/2B or A1/A2/B1/B2

Use the labels printed on your driver board. Leave MS1 and MS2 unconnected; that sets UART address 0.

Check Board soldered and every row of the table checked against it

C3

### Power check, boards out

DONE

1. Set the trigger board to 9 V (a button on some boards, a solder jumper on others). Plug it into the power bank and measure 9.0 V ± 0.3 at its output before it touches the board.
2. Connect it to the board with neither the Pico nor the driver plugged in, and measure the four points below.
3. Unplug the power.

Check with the multimeter 9 V between the driver socket's VM and GND 5.0 V at the 7805 OUT 4.6–5.0 V between Pico socket pins 39 (VSYS) and 38 (GND). With nothing plugged in it reads close to 5.0 About 1.9 V between pin 31 (GP26) and GND Nothing gets warm

From here on, "unplug the power" means both the 9 V and the laptop USB cable, whenever a board or cable goes in or out.

C4

### Pico in: test 1

DONE

Plug the Pico into its socket, driver still out. Connect the laptop, then the 9 V. In the Thonny shell:

import bench bench.t1_power()

Check It prints about 9 V and "OK". With the 9 V unplugged it prints "none"

C5

### Driver in: set the current, then test 3

DONE

1. Unplug the power. Plug the driver into its socket. The motor stays disconnected.
2. Plug in the 9 V. Measure between the small pot on the driver and GND, and turn the pot with a plastic or ceramic screwdriver until it reads 0.99 V. That sets a 0.70 A ceiling on the BTT TMC2209 V1.3. On a different driver board, work out its VREF for 0.70 A from its sense resistor first.
3. In Thonny, run the test.

bench.t3_driver()

Check VREF reads 0.99 V It prints "version 0x21" and "Settings taken … 1/16"

C6

### Make the motor cable

DONE

The motor has 4 wires in 2 coil pairs. Find the pairs with the multimeter on ohms: wires of the same pair read about 2.2 Ω, wires from different pairs read open.

- One pair goes to the driver's first coil pins (1A/1B), the other to the second (2A/2B).
- If the motor later turns the wrong way, the software fixes it in test F4. There's no need to swap wires.

Don't connect the motor to the board yet.

Check Coil pairs found and the cable made

D

## Mechanical assembly

The order matters. Step D10 uses epoxy and needs a night to cure.

D1

### Clean up the prints

DONE

Don't drill the Ø3.9 dowel press holes in the base. The cover's dowel holes are oversize on purpose.

Check A 4.0 mm drill turned by hand passes through every pivot bore in the cranks, conrods, fingers and carriage Brims and strings removed, and the carriage tongue slides along the base channel

D2

### Heat-set inserts: 28 in all

DONE

Set the iron to about 230 °C. Rest the insert on its hole and let it sink under its own weight plus light pressure, until it's flush with the face it goes in from. Keep it straight.

Part | Inserts | Where
BellCrank Lower U and L | 2 each | F1 and D
FrontCrank Lower ×2 | 1 each | F2
Carriage | 2 | Lower ears. Press from underneath (the upper ear is in the way from above) until level with the lower ear's upper face. A shoulder screw should seat on it
Fingers ×2 | 2 each | In the underside of the tongue
Base | 6 | 2 at the motor-wall joint, 2 at the bearing-block ears, 2 posts
Adapter | 4 | Side holes
Cover top | 6 | 4 for the controller board, 2 for the electronics cover

Check 28 inserts in, all flush and straight

D3

### Locating pins and dowels

DONE

1. Locating pins: screw two M3×16 screws into the bearing-block half of the base until 8 mm of thread is in. Then cut the heads off and deburr the ends.
2. Dowels: cut each 4 × 40 dowel to 38.5 mm with the abrasive cut-off disc. Deburr the cut end.
3. Press them up through the base from underneath at O1 and O2 on both sides, square to the plate, until flush with the underside. Use the vise with soft jaws, and put a tube or drilled block over the dowel on the top side: about 29.5 mm comes out there.
4. Smear wax or grease on the top 8 mm of each dowel, so the epoxy in D10 doesn't stick to it.

Don't fit the bronze bushings yet. The cranks have to go over the dowels first. The bushings go on in D10.

Check 2 pins and 4 dowels in, dowels flush underneath and square

The base plate with four dowels entering from below, two short locating pins above the bearing block and four bronze bushings floating above the dowel positions.

Dowels come up from below. The bushings shown above them wait until D10.

D4

### Prepare the lead screw

DONE

1. Collar pull test: tighten the lock collar's set screw on the end of the screw and pull hard by hand. It must not slip. Then take it off.
2. Cut the screw to 73.0 mm from the motor's mounting face (71.0 mm past the round pilot), tolerance −0.5 / +0. Never long: the encoder puck fills the last 3 mm.
3. File a small chamfer on the cut end, clean off the chips and grease the thread.

Check Collar held in the pull test Screw cut to length (measured twice) and greased

D5

### Nut, carriage, collar and bearing onto the screw

DONE

1. Slide the brass nut into the carriage from the front: body into the bore, flange into the front recess, holes at 3 and 9 o'clock. Fit 2× M3×8, snug only.
2. Spin the carriage onto the screw.
3. Slide on the lock collar with its set screw loose, then the 608.

Check Order on the screw from the motor: carriage with nut, collar, 608

The motor and lead screw with the carriage on the screw, then the lock collar and the 608 bearing shown spaced out along the axis.

Carriage, then collar, then bearing.

D6

### Drive into the base

DONE

1. Lay it all into the base with the motor connector facing up:
  - the pilot goes in the wall recess;
  - the carriage tongue goes in the channel;
  - the 608 sits in its cradle against the front lip, collar behind it.
2. Fit the 2 lower motor screws (M3×8) through the access slots with the 2 mm ball-end.
3. Push the collar forward until it just touches the 608 inner ring, with no preload, and tighten its set screw.
4. Turn the motor shaft by hand. The carriage must run end to end without binding. Then tighten the 2 nut screws.

Check The carriage runs the full length smoothly by hand

The motor, lead screw, carriage, collar and bearing as one unit being lowered into the base plate.

The whole drive lowers in as one unit.

D7

### Encoder

DONE

1. Glue the magnet into the puck, flush. Push the puck into the 608 bore against the screw end and fix it there with a drop of CA.
2. Solder 4 wires (VCC, GND, SDA, SCL) to the AS5600 pad row, plus a short link from DIR to GND.
3. Drop the board into the slot in front of the 608, chip toward the magnet and pads up.

Check Board fully down in its slot, chip side facing the magnet, 4 wires pointing up

The small encoder board dropping into a slot in front of the bearing, with the magnet puck going into the bearing bore.

Puck into the bearing, board into the slot in front of it.

D8

### Linkage, both sides

DONE

Parts marked U and L are mirror images, one for each side. If a part doesn't sit flat with its boss up, it belongs on the other side.

1. BellCrank Lower on O1 and FrontCrank Lower on O2, bosses up.
2. Finger onto F1 and F2. Conrod onto D, and between the carriage ears at C.
3. BellCrank Upper and FrontCrank Upper on top.
4. Shoulder screws at F1, F2, D and C, into the inserts. Snug only.

Check Pushing one finger moves both jaws together, smoothly, over the full range

Four lower crank plates dropping onto the four dowels.

1. Lower plates onto the dowels.

The two fingers and two connecting rods being placed on the lower crank plates.

2. Fingers and conrods.

The upper crank plates going on top, with eight shoulder screws above them.

3 and 4. Upper plates, then 8 shoulder screws.

D9

### Tip blocks and pads

DONE

Fit the narrow set first.

1. Slide a TPU pad into a tip block's groove from the rear and press until its barb snaps past the step. A drop of soapy water helps.
2. Push the tip block up onto the finger tongue from below, and fit 2× M3×10 from below.

Check Both tip blocks on with 2 screws each, pads snapped in and facing each other

The gripper seen from underneath, with the two tip blocks and their screws going up onto the finger tongues.

Seen from underneath: blocks and screws go on from below.

D10

### Cover and bushings, then wait overnight

DONE

1. Thread the encoder wires up through the slit in the cover as you lower it, and check the motor connector is free.
2. Put a little epoxy into the 4 oversize dowel holes in the cover, and lower the cover over the dowels.
3. Push a bronze bushing down over each dowel top into its hole, until the bushing's top is about 1.4 mm below the cover top. Wipe any epoxy off the dowel tops.
4. Fit the cover screws: 2× M3×20 at the motor wall, 2× M3×20 at the bearing-block ears, 2× M3×8 at the posts, then the 2 upper motor screws (M3×8) through the cover slots.
5. Let it cure fully, overnight, with everything assembled. The bushings bond exactly where the dowels are.

A bushing must not rest on the crank underneath. Look again after 10 minutes and lift any that has slid down.

Check the next day, power off The jaws push open and closed by hand over the full range: smooth, no clicks, no rubbing

Once the controller is on, two cover screws sit under its board. To take the cover off later, remove the controller first.

The dark cover plate being lowered onto the assembled gripper, with eight screws above it.

Cover down, bushings in, 8 screws.

E

## Controller onto the gripper

E1

### Mount the board and its cover

DONE

1. Unplug the Pico and the driver from their sockets. Put the 4 printed spacers (4 mm) on the cover-top inserts, set the board on them, and fit 4× M3×10 through the board and spacers. Then plug the Pico and driver back in.
2. Power off: connect the motor cable to the driver and the AS5600 lead to the board.
3. Zip-tie each cable (USB, power, motor, encoder) to the board as strain relief.
4. Lower the electronics cover over the board with the cables in its notches:
  - both USB-C cables through the two notches in the short wall at the USB end;
  - motor cable at the motor end;
  - encoder wires at the jaw end.
5. Fit 2× M3×8 through its flanges. Do this before plugging in the Pico's USB cable: the plug sits over one of the screws.

Check Board held by 4 screws, all 4 cables tied down Cover on with 2 screws, no cable pinched, and the BOOTSEL button reachable through the window in its top

The electronics cover with its vents and window being lowered over the controller board on top of the gripper.

The cover goes on last, held by 2 screws.

F

## First powered tests

Set the gripper on the bench, or clamp it in its stand first (Part G). Plug in the laptop, then the 9 V. Run the tests in order.

F1–F6

### Six tests, in order

DONE

import bench # once per session

Run each command, tick when it passes bench.t1_power() prints about 9 V and "OK" bench.t2_encoder() while you push the jaws by hand: "magnet OK", and the angle and turns change as the jaws move bench.t3_driver() prints "version 0x21" and the settings taken bench.t4_direction(): follow the prompts with the jaws half open. It moves 2 mm and you answer y/n. Ends with "Saved: dir_close=…, enc_sign=…" bench.t5_tracking() with the jaws about half open (it moves 4 mm each way): both moves "OK" bench.t6_home() prints "Homed" and the pads then open to 30 mm, within 1 mm on the calipers

"Homed" alone is not a pass. If the encoder isn't counting, it says "Homed" straight away without closing. The 30 mm caliper reading is the real test.

F7

### Try the gripper

DONE

bench.goto(40) # open to 40 mm bench.grip() # put an object between the pads first bench.goto(40) # release

Check Grip test: it grips an object of about 500 g that is 30–55 mm wide (a slim bottle, or a small jar with coins in it). When you let go, the object hangs without slipping, even when shaken gently Wide tips: run bench.off(), swap to the wide tip blocks (2 screws each side), then bench.tips('wide'), bench.home() and bench.goto(60). The pads are 60 mm apart

A standard 500 ml bottle is about 65 mm wide, too wide for the narrow tips. Test it with the wide tips and bench.goto(75).

G

## Bench stand and desk clamps

G1

### Build the stand

DONE

1. Slide the T-nuts into the column's slots first: 2 near the bottom for the base socket and 2 for the head bracket.
2. Push the column into the base socket and fit 2× M5×12 through the socket walls into the T-nuts. Optional: M5×12 from below into the column end, if you tapped it M5.
3. Drop an M8 nut into the slot of each desk clamp and thread a star knob in from below. Seat a TPU clamp pad on the knob's screw tip, socket side down.
4. Put the base on the desk with its front edge flush with the desk's front edge. Hook a clamp over each front corner (its boss drops into the corner counterbore) and tighten the knobs by hand.
5. Slide the head bracket onto the column and lock it with 2× M5×12 into its T-nuts. Drop 4 M6 nuts into the bracket pockets from the back.
6. Bolt the adapter to the bracket with 4× M6×20. Slide the gripper onto the adapter (the U-slot is open at the rear) and fit 4× M3×8 through the side walls.

Always clamp it. The stand tips over if it isn't clamped to the desk.

Check The stand doesn't move when you push the gripper sideways

The gripper hanging jaws-down from a head bracket on an aluminium column, on a printed base plate held to the desk edge by two clamps.

Jaws down, base clamped to the desk edge.

H

## Demo mode and taking it with you

H1

### Stand-alone demo, no laptop

DONE

Save main.py on the Pico next to bench.py. From then on, plugging the USB-C cable into a power bank makes the gripper home itself and open. Each press of the Pico's BOOTSEL button then grips or releases. To stop the demo, connect Thonny, or delete main.py from the Pico.

Check On power bank only: it homes, opens, and grips and releases on each button press

A power bank that switches itself off: some banks turn off when little current is drawn. The driver's hold current normally keeps the bank awake. If yours still switches off, press its button, or use another bank or a wall charger.

H2

### Portable kit

DONE

Pack Gripper on its stand, or the stand in pieces 2 desk clamps (they fit edges 24–49 mm thick) Power bank, charged, and its USB-C cable Backup power: any USB-C laptop or phone charger of 18 W or more also gives 9 V A few objects to grip, and the wide tips with 4 M3×10 screws and a 2 mm key Laptop and USB cable, if you want to show ROS 2 control

I

## Troubleshooting

What you see | Likely cause | Fix
t1_power reads 0 V with power plugged in | Trigger board not at 9 V, or a divider wiring error | Measure the trigger output; check the 100 k / 27 k to GP26
t1_power reads 5 V | The trigger board fell back to 5 V: the bank or charger isn't PD, or the trigger isn't set | Use a PD source; set the trigger to 9 V
"AS5600 not found" | Wiring | VCC to 3V3, SDA to GP0, SCL to GP1, DIR to GND; check solder joints
"magnet too weak / not detected" | Board not centred on the magnet, or too far away | Board fully down in its slot, chip side toward the magnet
t3_driver: "No reply" | UART wiring or no 9 V | 1 k from GP8 to the UART pin, GP9 straight to the same pin; 9 V present; driver the right way round
Motor buzzes but doesn't turn | A coil pair is split across the two driver outputs | Redo C6 with the power off: each pair on its own output
Motor turns, encoder doesn't count | Encoder cable or magnet | t2_encoder() while turning the jaws by hand
t5_tracking off by a lot | Steps lost: binding in the mechanism, or the current too low | Power off and check the hand movement; check VREF is 0.99 V
Says "Homed" at once but the jaws didn't close, or the F6 gap is wrong | Encoder not counting, or its direction saved wrongly | t2_encoder(), then t4_direction() again
"Homing failed (…)" | The jaws never stopped within 40 mm, or a power or driver fault | Read the reason in the brackets; run t5_tracking()
Jaws open by themselves when the power is off | Normal: the screw back-drives | Keep the power on to hold a grip
Driver very hot | VREF set too high | Set VREF to 0.99 V. Warm is normal; too hot to touch is not
Gripper slips on objects | Low current at large gaps, or a dry screw | Grease the screw; note the gap and the object, and check CURRENT_TABLE

Progress is saved in this browser only. Clear all ticks
