anuragbhandari-eng/Gripper_V2/gripper_fabrication_rev7/images/build_guide_rev7/d8a_lower.webp

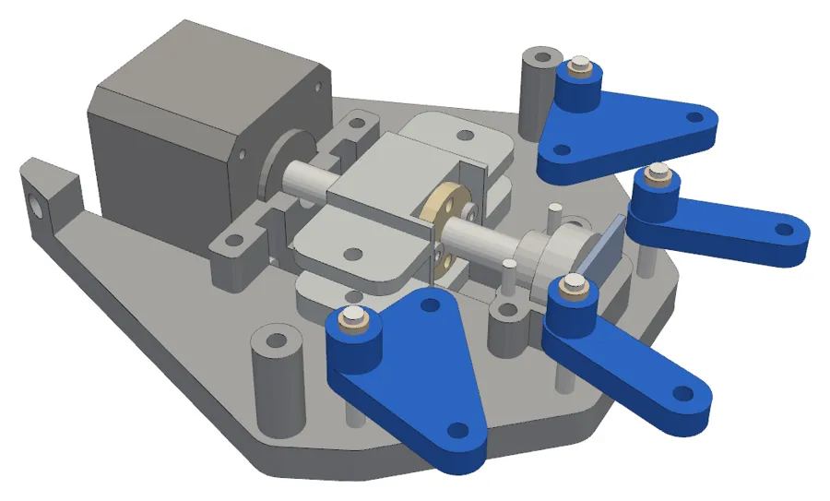
gripper_fabrication_rev7/images/build_guide_rev7/d8a_lower.webp
