anuragbhandari-eng/Gripper_V2/gripper_fabrication_rev7/images/onshape_v2_assembly_front.png

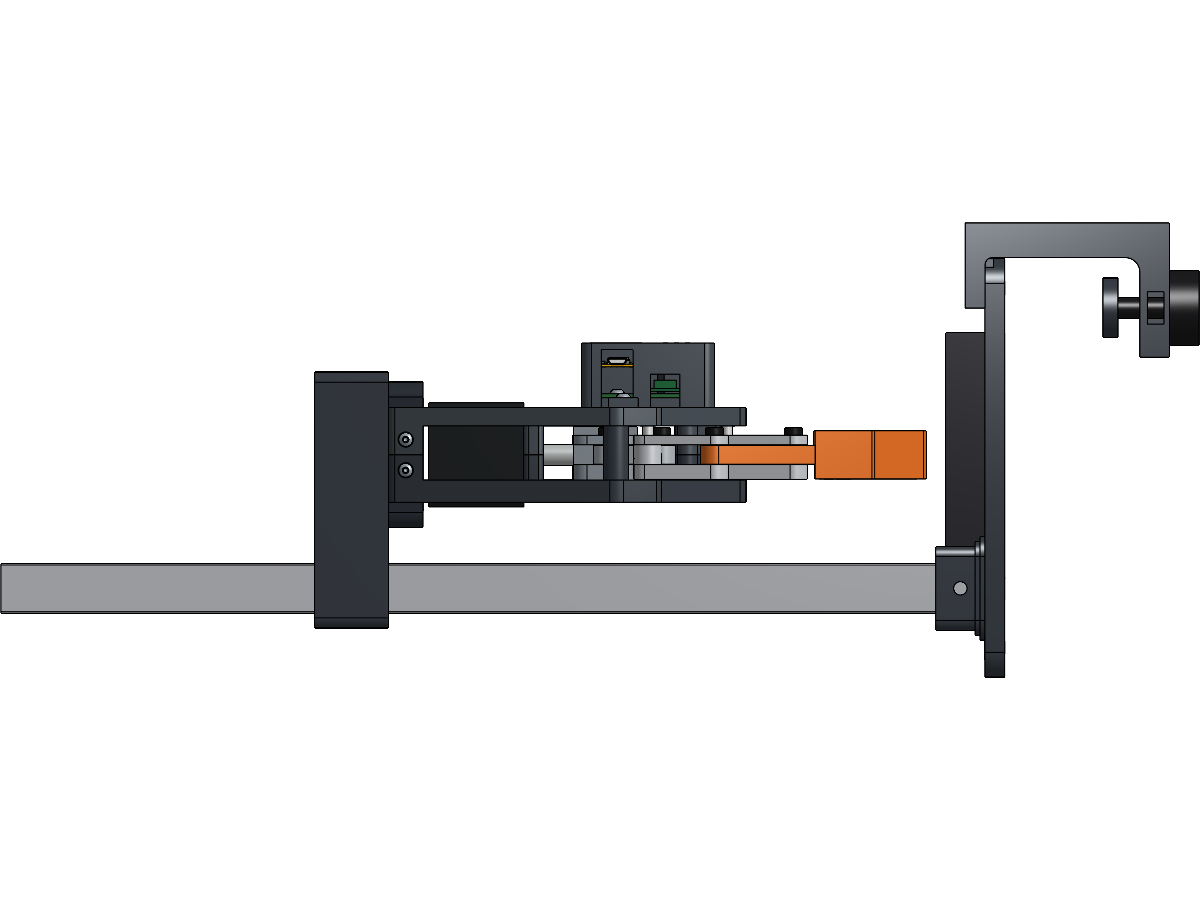
gripper_fabrication_rev7/images/onshape_v2_assembly_front.png
