anuragbhandari-eng/Gripper_V2/gripper_fabrication_rev7/images/onshape_v2_assembly_top.png

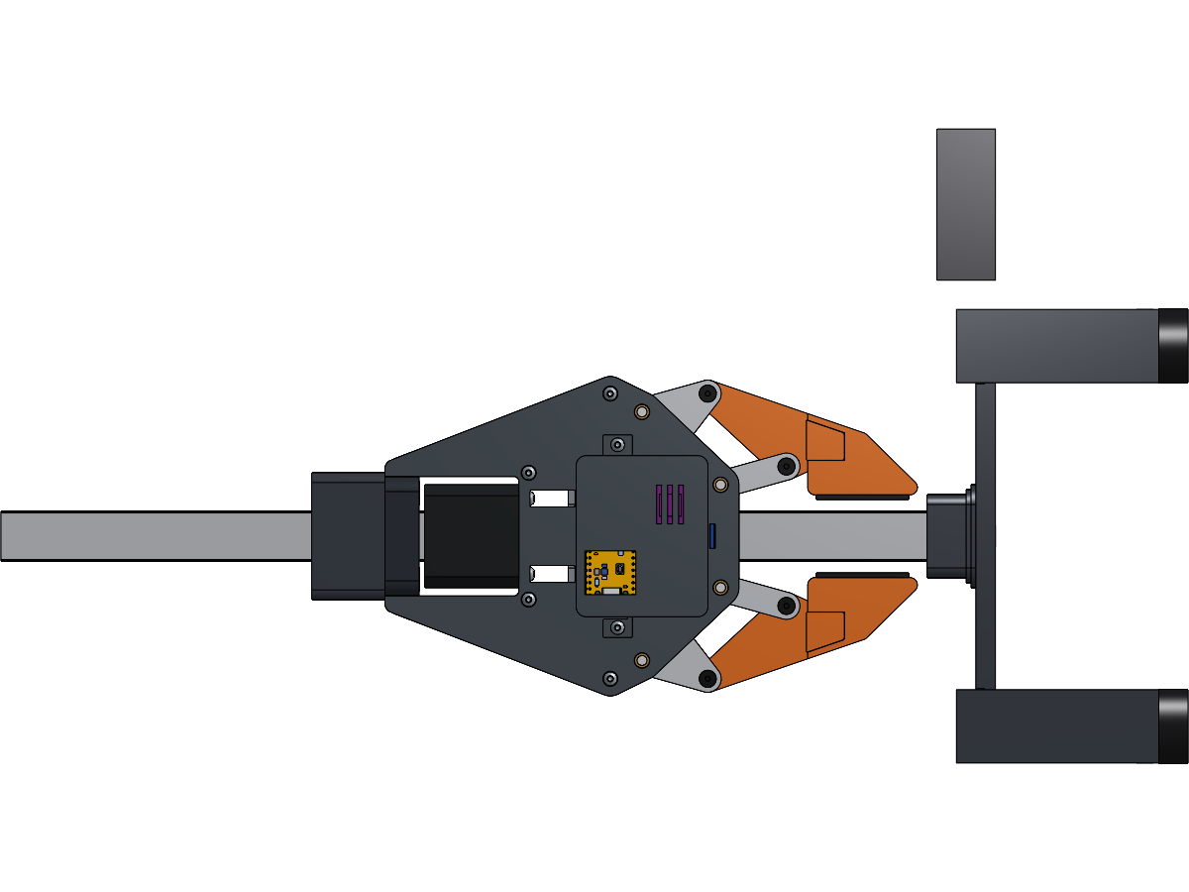
gripper_fabrication_rev7/images/onshape_v2_assembly_top.png
