anuragbhandari-eng/Gripper_V2/gripper_fabrication_rev7/images/render_stand.png

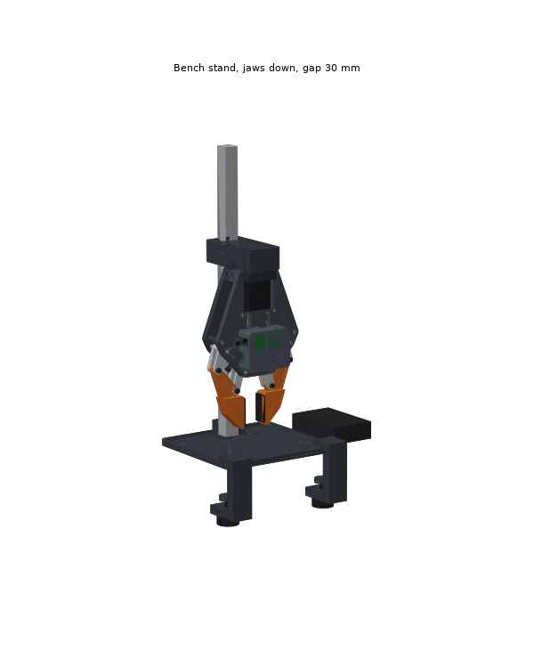
gripper_fabrication_rev7/images/render_stand.png
