anuragbhandari-eng/Gripper_V2/gripper_fabrication_rev7/images/sections_final.png

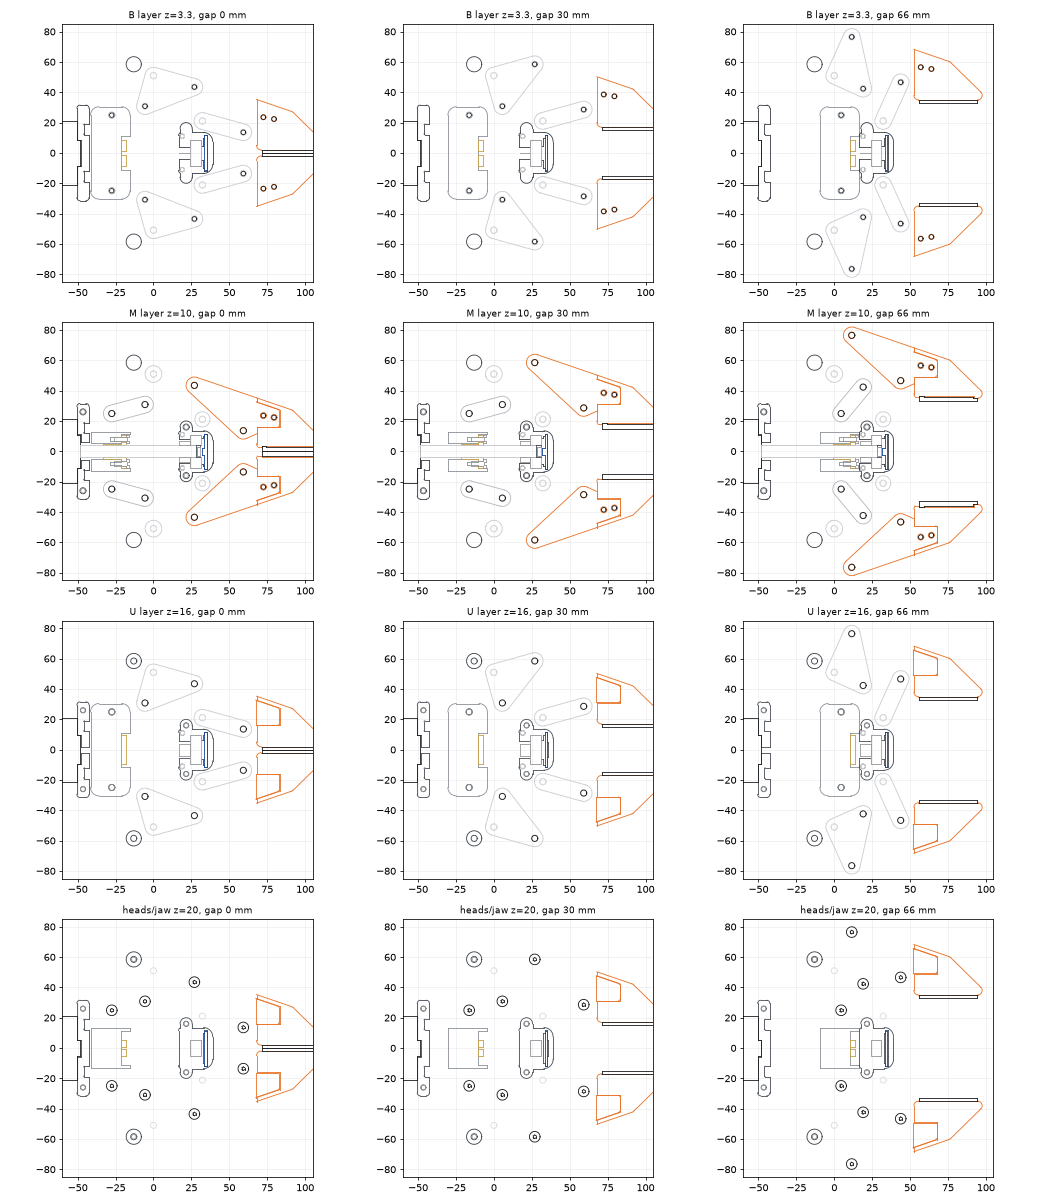
gripper_fabrication_rev7/images/sections_final.png
