anuragbhandari-eng/Gripper_V2/gripper_fabrication_rev7/source/step2_kinematics.png

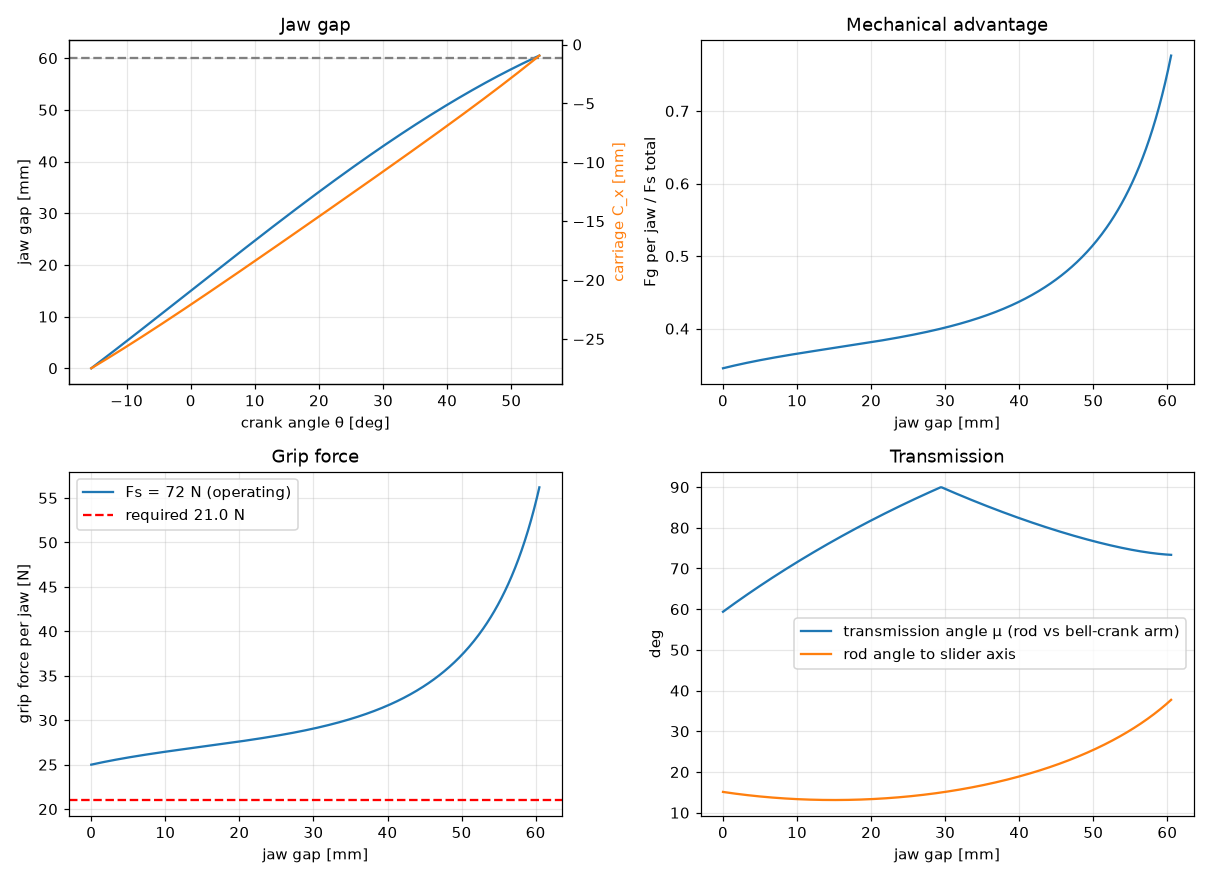
gripper_fabrication_rev7/source/step2_kinematics.png
