anuragbhandari-eng/Gripper_V2/ros2_ws/src/lead_screw_gripper_description/onshape_render/lead_screw_gripper_render.urdf

<?xml version="1.0" ?>
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
<robot name="lead_screw_gripper">
  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
  <link name="base_link">
    <inertial>
      <origin xyz="0 0 0" rpy="0 0 0"/>
      <mass value="1e-09"/>
      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
    </inertial>
  </link>
  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
  <link name="bell_crank_U_link">
    <inertial>
      <origin xyz="0 0 0" rpy="0 0 0"/>
      <mass value="1e-09"/>
      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
    </inertial>
  </link>
  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
  <link name="finger_U_link">
    <inertial>
      <origin xyz="0 0 0" rpy="0 0 0"/>
      <mass value="1e-09"/>
      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
    </inertial>
  </link>
  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
  <link name="closing_F2_U_2">
    <origin xyz="0 0 0" rpy="0 -0 0"/>
    <inertial>
      <origin xyz="0 0 0" rpy="0 0 0"/>
      <mass value="1e-9"/>
      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
    </inertial>
  </link>
  <joint name="closing_F2_U_2_frame" type="fixed">
    <origin xyz="0.00641464 0.0435115 0" rpy="3.14159 -0 0.677441"/>
    <parent link="finger_U_link"/>
    <child link="closing_F2_U_2"/>
    <axis xyz="0 0 0"/>
  </joint>
  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
  <link name="finger_U_link_socket_button_head_screw_m3x0_5_x_10__ab5dc1006d13f2491c23b78383e7390f_5">
    <inertial>
      <origin xyz="0 0 0" rpy="0 0 0"/>
      <mass value="1e-09"/>
      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
    </inertial>
    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
  </link>
  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
  <joint name="finger_U_link_socket_button_head_screw_m3x0_5_x_10__ab5dc1006d13f2491c23b78383e7390f_5_fixed" type="fixed">
    <origin xyz="0.027663 0.0493705 0.00955" rpy="-0 -0 0.677441"/>
    <parent link="finger_U_link"/>
    <child link="finger_U_link_socket_button_head_screw_m3x0_5_x_10__ab5dc1006d13f2491c23b78383e7390f_5"/>
    <axis xyz="0 0 1"/>
    <limit effort="10" velocity="10"/>
  </joint>
  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
  <link name="finger_U_link_tip_block_u">
    <inertial>
      <origin xyz="0.0875744 0.0285466 0.00985642" rpy="0 0 0"/>
      <mass value="0.016744"/>
      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
    </inertial>
    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
  </link>
  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
  <joint name="finger_U_link_tip_block_u_fixed" type="fixed">
    <origin xyz="-0.0576722 0.0286571 0.01025" rpy="3.14159 -0 0.677441"/>
    <parent link="finger_U_link"/>
    <child link="finger_U_link_tip_block_u"/>
    <axis xyz="0 0 1"/>
    <limit effort="10" velocity="10"/>
  </joint>
  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
  <link name="finger_U_link_socket_button_head_screw_m3x0_5_x_10__ab5dc1006d13f2491c23b78383e7390f_6">
    <inertial>
      <origin xyz="0 0 0" rpy="0 0 0"/>
      <mass value="1e-09"/>
      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
    </inertial>
    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
  </link>
  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
  <joint name="finger_U_link_socket_button_head_screw_m3x0_5_x_10__ab5dc1006d13f2491c23b78383e7390f_6_fixed" type="fixed">
    <origin xyz="0.0229598 0.0440493 0.00955" rpy="-0 -0 0.677441"/>
    <parent link="finger_U_link"/>
    <child link="finger_U_link_socket_button_head_screw_m3x0_5_x_10__ab5dc1006d13f2491c23b78383e7390f_6"/>
    <axis xyz="0 0 1"/>
    <limit effort="10" velocity="10"/>
  </joint>
  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
  <link name="finger_U_link_finger_u">
    <inertial>
      <origin xyz="0.0554978 0.0431044 0.0111531" rpy="0 0 0"/>
      <mass value="0.0106006"/>
      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
    </inertial>
    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
  </link>
  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
  <joint name="finger_U_link_finger_u_fixed" type="fixed">
    <origin xyz="-0.0576722 0.0286571 0.01025" rpy="3.14159 -0 0.677441"/>
    <parent link="finger_U_link"/>
    <child link="finger_U_link_finger_u"/>
    <axis xyz="0 0 1"/>
    <limit effort="10" velocity="10"/>
  </joint>
  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
  <link name="finger_U_link_pad_tpu_u">
    <inertial>
      <origin xyz="0.0902348 0.0162108 0.0103" rpy="0 0 0"/>
      <mass value="0.00206959"/>
      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
    </inertial>
    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
  </link>
  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
  <joint name="finger_U_link_pad_tpu_u_fixed" type="fixed">
    <origin xyz="-0.0576722 0.0286571 0.01025" rpy="3.14159 -0 0.677441"/>
    <parent link="finger_U_link"/>
    <child link="finger_U_link_pad_tpu_u"/>
    <axis xyz="0 0 1"/>
    <limit effort="10" velocity="10"/>
  </joint>
  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
  <joint name="finger_U" type="revolute">
    <origin xyz="0.0163121 -0.0227578 0" rpy="0 0 -0.677441"/>
    <parent link="bell_crank_U_link"/>
    <child link="finger_U_link"/>
    <axis xyz="0 0 1"/>
    <limit effort="20" velocity="10" lower="-1.2198" upper="0"/>
  </joint>
  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
  <link name="conrod_U_link">
    <inertial>
      <origin xyz="0 0 0" rpy="0 0 0"/>
      <mass value="1e-09"/>
      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
    </inertial>
  </link>
  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
  <link name="closing_C_U_2">
    <origin xyz="0 0 0" rpy="0 -0 0"/>
    <inertial>
      <origin xyz="0 0 0" rpy="0 0 0"/>
      <mass value="1e-9"/>
      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
    </inertial>
  </link>
  <joint name="closing_C_U_2_frame" type="fixed">
    <origin xyz="-0.022671 -0.000431263 0" rpy="3.14159 0 0.282782"/>
    <parent link="conrod_U_link"/>
    <child link="closing_C_U_2"/>
    <axis xyz="0 0 0"/>
  </joint>
  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
  <link name="conrod_U_link_conrod_u">
    <inertial>
      <origin xyz="-0.00533876 0.0278704 0.0103" rpy="0 0 0"/>
      <mass value="0.0025036"/>
      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
    </inertial>
    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
  </link>
  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
  <joint name="conrod_U_link_conrod_u_fixed" type="fixed">
    <origin xyz="-0.0139854 0.0280375 0.01025" rpy="3.14159 0 0.282782"/>
    <parent link="conrod_U_link"/>
    <child link="conrod_U_link_conrod_u"/>
    <axis xyz="0 0 1"/>
    <limit effort="10" velocity="10"/>
  </joint>
  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
  <joint name="conrod_U" type="revolute">
    <origin xyz="0.0169948 0.0121814 0" rpy="0 0 -0.677441"/>
    <parent link="bell_crank_U_link"/>
    <child link="conrod_U_link"/>
    <axis xyz="0 0 1"/>
    <limit effort="0.5" velocity="10" lower="-0.825" upper="0"/>
  </joint>
  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
  <link name="bell_crank_U_link_shoulder_screw_4x12_m3_d_u">
    <inertial>
      <origin xyz="0.00560669 0.0308262 0.0141949" rpy="0 0 0"/>
      <mass value="0.00229081"/>
      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
    </inertial>
    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
  </link>
  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
  <joint name="bell_crank_U_link_shoulder_screw_4x12_m3_d_u_fixed" type="fixed">
    <origin xyz="0.0319481 0.0397148 0.01025" rpy="-3.14159 0 -0.677441"/>
    <parent link="bell_crank_U_link"/>
    <child link="bell_crank_U_link_shoulder_screw_4x12_m3_d_u"/>
    <axis xyz="0 0 1"/>
    <limit effort="10" velocity="10"/>
  </joint>
  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
  <link name="bell_crank_U_link_bellcrank_upper_u">
    <inertial>
      <origin xyz="0.0117313 0.0469504 0.0163" rpy="0 0 0"/>
      <mass value="0.00319604"/>
      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
    </inertial>
    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
  </link>
  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
  <joint name="bell_crank_U_link_bellcrank_upper_u_fixed" type="fixed">
    <origin xyz="0.0319481 0.0397148 0.01025" rpy="-3.14159 0 -0.677441"/>
    <parent link="bell_crank_U_link"/>
    <child link="bell_crank_U_link_bellcrank_upper_u"/>
    <axis xyz="0 0 1"/>
    <limit effort="10" velocity="10"/>
  </joint>
  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
  <link name="bell_crank_U_link_shoulder_screw_4x12_m3_f1_u">
    <inertial>
      <origin xyz="0.0269746 0.058478 0.0141949" rpy="0 0 0"/>
      <mass value="0.00229081"/>
      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
    </inertial>
    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
  </link>
  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
  <joint name="bell_crank_U_link_shoulder_screw_4x12_m3_f1_u_fixed" type="fixed">
    <origin xyz="0.0319481 0.0397148 0.01025" rpy="-3.14159 0 -0.677441"/>
    <parent link="bell_crank_U_link"/>
    <child link="bell_crank_U_link_shoulder_screw_4x12_m3_f1_u"/>
    <axis xyz="0 0 1"/>
    <limit effort="10" velocity="10"/>
  </joint>
  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
  <link name="bell_crank_U_link_bellcrank_lower_u">
    <inertial>
      <origin xyz="0.0103382 0.0474267 0.00414047" rpy="0 0 0"/>
      <mass value="0.00573882"/>
      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
    </inertial>
    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
  </link>
  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
  <joint name="bell_crank_U_link_bellcrank_lower_u_fixed" type="fixed">
    <origin xyz="0.0319481 0.0397148 0.01025" rpy="-3.14159 0 -0.677441"/>
    <parent link="bell_crank_U_link"/>
    <child link="bell_crank_U_link_bellcrank_lower_u"/>
    <axis xyz="0 0 1"/>
    <limit effort="10" velocity="10"/>
  </joint>
  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
  <joint name="bell_crank_U" type="revolute">
    <origin xyz="0 0.0509701 0.01025" rpy="3.14159 -0 0"/>
    <parent link="base_link"/>
    <child link="bell_crank_U_link"/>
    <axis xyz="0 0 1"/>
    <limit effort="3" velocity="10" lower="0" upper="1.2198"/>
  </joint>
  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
  <link name="front_crank_U_link">
    <inertial>
      <origin xyz="0 0 0" rpy="0 0 0"/>
      <mass value="1e-09"/>
      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
    </inertial>
  </link>
  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
  <link name="closing_F2_U_1">
    <origin xyz="0 0 0" rpy="0 -0 0"/>
    <inertial>
      <origin xyz="0 0 0" rpy="0 0 0"/>
      <mass value="1e-9"/>
      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
    </inertial>
  </link>
  <joint name="closing_F2_U_1_frame" type="fixed">
    <origin xyz="0.0163121 -0.0227578 0" rpy="3.14159 -0 -0.677441"/>
    <parent link="front_crank_U_link"/>
    <child link="closing_F2_U_1"/>
    <axis xyz="0 0 0"/>
  </joint>
  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
  <link name="front_crank_U_link_shoulder_screw_4x12_m3_f2_u">
    <inertial>
      <origin xyz="0.0592458 0.0285955 0.0141949" rpy="0 0 0"/>
      <mass value="0.00229081"/>
      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
    </inertial>
    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
  </link>
  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
  <joint name="front_crank_U_link_shoulder_screw_4x12_m3_f2_u_fixed" type="fixed">
    <origin xyz="-0.0119273 0.0366587 0.01025" rpy="3.14159 -0 -0.677441"/>
    <parent link="front_crank_U_link"/>
    <child link="front_crank_U_link_shoulder_screw_4x12_m3_f2_u"/>
    <axis xyz="0 0 1"/>
    <limit effort="10" velocity="10"/>
  </joint>
  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
  <link name="front_crank_U_link_frontcrank_upper_u">
    <inertial>
      <origin xyz="0.0457819 0.0248481 0.0163" rpy="0 0 0"/>
      <mass value="0.00148586"/>
      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
    </inertial>
    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
  </link>
  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
  <joint name="front_crank_U_link_frontcrank_upper_u_fixed" type="fixed">
    <origin xyz="-0.0119273 0.0366587 0.01025" rpy="3.14159 -0 -0.677441"/>
    <parent link="front_crank_U_link"/>
    <child link="front_crank_U_link_frontcrank_upper_u"/>
    <axis xyz="0 0 1"/>
    <limit effort="10" velocity="10"/>
  </joint>
  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
  <link name="front_crank_U_link_frontcrank_lower_u">
    <inertial>
      <origin xyz="0.0432573 0.0241454 0.004627" rpy="0 0 0"/>
      <mass value="0.00289497"/>
      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
    </inertial>
    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
  </link>
  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
  <joint name="front_crank_U_link_frontcrank_lower_u_fixed" type="fixed">
    <origin xyz="-0.0119273 0.0366587 0.01025" rpy="3.14159 -0 -0.677441"/>
    <parent link="front_crank_U_link"/>
    <child link="front_crank_U_link_frontcrank_lower_u"/>
    <axis xyz="0 0 1"/>
    <limit effort="10" velocity="10"/>
  </joint>
  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
  <joint name="front_crank_U" type="revolute">
    <origin xyz="0.0322712 0.0210876 0.01025" rpy="3.14159 -0 0"/>
    <parent link="base_link"/>
    <child link="front_crank_U_link"/>
    <axis xyz="0 0 1"/>
    <limit effort="1" velocity="10" lower="0" upper="1.2198"/>
  </joint>
  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
  <link name="bell_crank_L_link">
    <inertial>
      <origin xyz="0 0 0" rpy="0 0 0"/>
      <mass value="1e-09"/>
      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
    </inertial>
  </link>
  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
  <link name="finger_L_link">
    <inertial>
      <origin xyz="0 0 0" rpy="0 0 0"/>
      <mass value="1e-09"/>
      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
    </inertial>
  </link>
  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
  <link name="closing_F2_L_2">
    <origin xyz="0 0 0" rpy="0 -0 0"/>
    <inertial>
      <origin xyz="0 0 0" rpy="0 0 0"/>
      <mass value="1e-9"/>
      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
    </inertial>
  </link>
  <joint name="closing_F2_L_2_frame" type="fixed">
    <origin xyz="0.00641464 -0.0435115 0" rpy="3.14159 -0 -0.677441"/>
    <parent link="finger_L_link"/>
    <child link="closing_F2_L_2"/>
    <axis xyz="0 0 0"/>
  </joint>
  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
  <link name="finger_L_link_pad_tpu_l">
    <inertial>
      <origin xyz="0.0902348 -0.0162108 0.0103" rpy="0 0 0"/>
      <mass value="0.00206959"/>
      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
    </inertial>
    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
  </link>
  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
  <joint name="finger_L_link_pad_tpu_l_fixed" type="fixed">
    <origin xyz="-0.0576722 -0.0286571 0.01025" rpy="-3.14159 -0 -0.677441"/>
    <parent link="finger_L_link"/>
    <child link="finger_L_link_pad_tpu_l"/>
    <axis xyz="0 0 1"/>
    <limit effort="10" velocity="10"/>
  </joint>
  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
  <link name="finger_L_link_socket_button_head_screw_m3x0_5_x_10__ab5dc1006d13f2491c23b78383e7390f_7">
    <inertial>
      <origin xyz="0 0 0" rpy="0 0 0"/>
      <mass value="1e-09"/>
      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
    </inertial>
    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
  </link>
  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
  <joint name="finger_L_link_socket_button_head_screw_m3x0_5_x_10__ab5dc1006d13f2491c23b78383e7390f_7_fixed" type="fixed">
    <origin xyz="0.0229598 -0.0440493 0.00955" rpy="-0 -0 -0.677441"/>
    <parent link="finger_L_link"/>
    <child link="finger_L_link_socket_button_head_screw_m3x0_5_x_10__ab5dc1006d13f2491c23b78383e7390f_7"/>
    <axis xyz="0 0 1"/>
    <limit effort="10" velocity="10"/>
  </joint>
  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
  <link name="finger_L_link_finger_l">
    <inertial>
      <origin xyz="0.0554978 -0.0431044 0.0111531" rpy="0 0 0"/>
      <mass value="0.0106006"/>
      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
    </inertial>
    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
  </link>
  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
  <joint name="finger_L_link_finger_l_fixed" type="fixed">
    <origin xyz="-0.0576722 -0.0286571 0.01025" rpy="3.14159 -0 -0.677441"/>
    <parent link="finger_L_link"/>
    <child link="finger_L_link_finger_l"/>
    <axis xyz="0 0 1"/>
    <limit effort="10" velocity="10"/>
  </joint>
  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
  <link name="finger_L_link_socket_button_head_screw_m3x0_5_x_10__ab5dc1006d13f2491c23b78383e7390f_8">
    <inertial>
      <origin xyz="0 0 0" rpy="0 0 0"/>
      <mass value="1e-09"/>
      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
    </inertial>
    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
  </link>
  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
  <joint name="finger_L_link_socket_button_head_screw_m3x0_5_x_10__ab5dc1006d13f2491c23b78383e7390f_8_fixed" type="fixed">
    <origin xyz="0.027663 -0.0493705 0.00955" rpy="-0 -0 -0.677441"/>
    <parent link="finger_L_link"/>
    <child link="finger_L_link_socket_button_head_screw_m3x0_5_x_10__ab5dc1006d13f2491c23b78383e7390f_8"/>
    <axis xyz="0 0 1"/>
    <limit effort="10" velocity="10"/>
  </joint>
  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
  <link name="finger_L_link_tip_block_l">
    <inertial>
      <origin xyz="0.0875744 -0.0285466 0.00985642" rpy="0 0 0"/>
      <mass value="0.0167439"/>
      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
    </inertial>
    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
  </link>
  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
  <joint name="finger_L_link_tip_block_l_fixed" type="fixed">
    <origin xyz="-0.0576722 -0.0286571 0.01025" rpy="-3.14159 -0 -0.677441"/>
    <parent link="finger_L_link"/>
    <child link="finger_L_link_tip_block_l"/>
    <axis xyz="0 0 1"/>
    <limit effort="10" velocity="10"/>
  </joint>
  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
  <joint name="finger_L" type="revolute">
    <origin xyz="0.0163121 0.0227578 0" rpy="0 -0 0.677441"/>
    <parent link="bell_crank_L_link"/>
    <child link="finger_L_link"/>
    <axis xyz="0 0 1"/>
    <limit effort="20" velocity="10" lower="0" upper="1.2198"/>
  </joint>
  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
  <link name="conrod_L_link">
    <inertial>
      <origin xyz="0 0 0" rpy="0 0 0"/>
      <mass value="1e-09"/>
      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
    </inertial>
  </link>
  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
  <link name="closing_C_L_2">
    <origin xyz="0 0 0" rpy="0 -0 0"/>
    <inertial>
      <origin xyz="0 0 0" rpy="0 0 0"/>
      <mass value="1e-9"/>
      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
    </inertial>
  </link>
  <joint name="closing_C_L_2_frame" type="fixed">
    <origin xyz="-0.022671 0.000431263 0" rpy="3.14159 0 -0.282782"/>
    <parent link="conrod_L_link"/>
    <child link="closing_C_L_2"/>
    <axis xyz="0 0 0"/>
  </joint>
  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
  <link name="conrod_L_link_conrod_l">
    <inertial>
      <origin xyz="-0.00533876 -0.0278704 0.0103" rpy="0 0 0"/>
      <mass value="0.0025036"/>
      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
    </inertial>
    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
  </link>
  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
  <joint name="conrod_L_link_conrod_l_fixed" type="fixed">
    <origin xyz="-0.0139854 -0.0280375 0.01025" rpy="3.14159 0 -0.282782"/>
    <parent link="conrod_L_link"/>
    <child link="conrod_L_link_conrod_l"/>
    <axis xyz="0 0 1"/>
    <limit effort="10" velocity="10"/>
  </joint>
  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
  <joint name="conrod_L" type="revolute">
    <origin xyz="0.0169948 -0.0121814 0" rpy="0 -0 0.677441"/>
    <parent link="bell_crank_L_link"/>
    <child link="conrod_L_link"/>
    <axis xyz="0 0 1"/>
    <limit effort="0.5" velocity="10" lower="0" upper="0.825"/>
  </joint>
  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
  <link name="bell_crank_L_link_bellcrank_upper_l">
    <inertial>
      <origin xyz="0.0117313 -0.0469504 0.0163" rpy="0 0 0"/>
      <mass value="0.00319604"/>
      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
    </inertial>
    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
  </link>
  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
  <joint name="bell_crank_L_link_bellcrank_upper_l_fixed" type="fixed">
    <origin xyz="0.0319481 -0.0397148 0.01025" rpy="-3.14159 -0 0.677441"/>
    <parent link="bell_crank_L_link"/>
    <child link="bell_crank_L_link_bellcrank_upper_l"/>
    <axis xyz="0 0 1"/>
    <limit effort="10" velocity="10"/>
  </joint>
  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
  <link name="bell_crank_L_link_shoulder_screw_4x12_m3_d_l">
    <inertial>
      <origin xyz="0.00560669 -0.0308262 0.0141949" rpy="0 0 0"/>
      <mass value="0.00229081"/>
      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
    </inertial>
    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
  </link>
  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
  <joint name="bell_crank_L_link_shoulder_screw_4x12_m3_d_l_fixed" type="fixed">
    <origin xyz="0.0319481 -0.0397148 0.01025" rpy="-3.14159 -0 0.677441"/>
    <parent link="bell_crank_L_link"/>
    <child link="bell_crank_L_link_shoulder_screw_4x12_m3_d_l"/>
    <axis xyz="0 0 1"/>
    <limit effort="10" velocity="10"/>
  </joint>
  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
  <link name="bell_crank_L_link_shoulder_screw_4x12_m3_f1_l">
    <inertial>
      <origin xyz="0.0269746 -0.058478 0.0141949" rpy="0 0 0"/>
      <mass value="0.00229081"/>
      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
    </inertial>
    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
  </link>
  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
  <joint name="bell_crank_L_link_shoulder_screw_4x12_m3_f1_l_fixed" type="fixed">
    <origin xyz="0.0319481 -0.0397148 0.01025" rpy="-3.14159 -0 0.677441"/>
    <parent link="bell_crank_L_link"/>
    <child link="bell_crank_L_link_shoulder_screw_4x12_m3_f1_l"/>
    <axis xyz="0 0 1"/>
    <limit effort="10" velocity="10"/>
  </joint>
  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
  <link name="bell_crank_L_link_bellcrank_lower_l">
    <inertial>
      <origin xyz="0.0103381 -0.0474267 0.00414047" rpy="0 0 0"/>
      <mass value="0.00573882"/>
      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
    </inertial>
    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
  </link>
  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
  <joint name="bell_crank_L_link_bellcrank_lower_l_fixed" type="fixed">
    <origin xyz="0.0319481 -0.0397148 0.01025" rpy="-3.14159 -0 0.677441"/>
    <parent link="bell_crank_L_link"/>
    <child link="bell_crank_L_link_bellcrank_lower_l"/>
    <axis xyz="0 0 1"/>
    <limit effort="10" velocity="10"/>
  </joint>
  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
  <joint name="bell_crank_L" type="revolute">
    <origin xyz="0 -0.0509701 0.01025" rpy="3.14159 -0 0"/>
    <parent link="base_link"/>
    <child link="bell_crank_L_link"/>
    <axis xyz="0 0 1"/>
    <limit effort="20" velocity="10" lower="-1.2198" upper="0"/>
  </joint>
  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
  <link name="front_crank_L_link">
    <inertial>
      <origin xyz="0 0 0" rpy="0 0 0"/>
      <mass value="1e-09"/>
      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
    </inertial>
  </link>
  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
  <link name="closing_F2_L_1">
    <origin xyz="0 0 0" rpy="0 -0 0"/>
    <inertial>
      <origin xyz="0 0 0" rpy="0 0 0"/>
      <mass value="1e-9"/>
      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
    </inertial>
  </link>
  <joint name="closing_F2_L_1_frame" type="fixed">
    <origin xyz="0.0163121 0.0227578 0" rpy="3.14159 -0 0.677441"/>
    <parent link="front_crank_L_link"/>
    <child link="closing_F2_L_1"/>
    <axis xyz="0 0 0"/>
  </joint>
  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
  <link name="front_crank_L_link_frontcrank_lower_l">
    <inertial>
      <origin xyz="0.0432573 -0.0241454 0.004627" rpy="0 0 0"/>
      <mass value="0.00289497"/>
      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
    </inertial>
    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
  </link>
  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
  <joint name="front_crank_L_link_frontcrank_lower_l_fixed" type="fixed">
    <origin xyz="-0.0119273 -0.0366587 0.01025" rpy="3.14159 -0 0.677441"/>
    <parent link="front_crank_L_link"/>
    <child link="front_crank_L_link_frontcrank_lower_l"/>
    <axis xyz="0 0 1"/>
    <limit effort="10" velocity="10"/>
  </joint>
  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
  <link name="front_crank_L_link_shoulder_screw_4x12_m3_f2_l">
    <inertial>
      <origin xyz="0.0592458 -0.0285955 0.0141949" rpy="0 0 0"/>
      <mass value="0.00229081"/>
      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
    </inertial>
    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
  </link>
  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
  <joint name="front_crank_L_link_shoulder_screw_4x12_m3_f2_l_fixed" type="fixed">
    <origin xyz="-0.0119273 -0.0366587 0.01025" rpy="3.14159 -0 0.677441"/>
    <parent link="front_crank_L_link"/>
    <child link="front_crank_L_link_shoulder_screw_4x12_m3_f2_l"/>
    <axis xyz="0 0 1"/>
    <limit effort="10" velocity="10"/>
  </joint>
  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
  <link name="front_crank_L_link_frontcrank_upper_l">
    <inertial>
      <origin xyz="0.0457819 -0.0248481 0.0163" rpy="0 0 0"/>
      <mass value="0.00148586"/>
      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
    </inertial>
    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
  </link>
  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
  <joint name="front_crank_L_link_frontcrank_upper_l_fixed" type="fixed">
    <origin xyz="-0.0119273 -0.0366587 0.01025" rpy="3.14159 -0 0.677441"/>
    <parent link="front_crank_L_link"/>
    <child link="front_crank_L_link_frontcrank_upper_l"/>
    <axis xyz="0 0 1"/>
    <limit effort="10" velocity="10"/>
  </joint>
  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
  <joint name="front_crank_L" type="revolute">
    <origin xyz="0.0322712 -0.0210876 0.01025" rpy="3.14159 -0 0"/>
    <parent link="base_link"/>
    <child link="front_crank_L_link"/>
    <axis xyz="0 0 1"/>
    <limit effort="1" velocity="10" lower="-1.2198" upper="0"/>
  </joint>
  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
  <link name="carriage_link">
    <inertial>
      <origin xyz="0 0 0" rpy="0 0 0"/>
      <mass value="1e-09"/>
      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
    </inertial>
  </link>
  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
  <link name="closing_C_U_1">
    <origin xyz="0 0 0" rpy="0 -0 0"/>
    <inertial>
      <origin xyz="0 0 0" rpy="0 0 0"/>
      <mass value="1e-9"/>
      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
    </inertial>
  </link>
  <joint name="closing_C_U_1_frame" type="fixed">
    <origin xyz="0.0249145 0 -0.015344" rpy="1.5708 1.5708 0"/>
    <parent link="carriage_link"/>
    <child link="closing_C_U_1"/>
    <axis xyz="0 0 0"/>
  </joint>
  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
  <link name="closing_C_L_1">
    <origin xyz="0 0 0" rpy="0 -0 0"/>
    <inertial>
      <origin xyz="0 0 0" rpy="0 0 0"/>
      <mass value="1e-9"/>
      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
    </inertial>
  </link>
  <joint name="closing_C_L_1_frame" type="fixed">
    <origin xyz="-0.0249145 0 -0.015344" rpy="1.5708 1.5708 0"/>
    <parent link="carriage_link"/>
    <child link="closing_C_L_1"/>
    <axis xyz="0 0 0"/>
  </joint>
  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
  <link name="carriage_link_shoulder_screw_4x12_m3_c_l">
    <inertial>
      <origin xyz="-0.0162842 -0.0249145 0.0141949" rpy="0 0 0"/>
      <mass value="0.00229081"/>
      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
    </inertial>
    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
  </link>
  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
  <joint name="carriage_link_shoulder_screw_4x12_m3_c_l_fixed" type="fixed">
    <origin xyz="0 0.01025 -0.0316282" rpy="1.5708 1.5708 0"/>
    <parent link="carriage_link"/>
    <child link="carriage_link_shoulder_screw_4x12_m3_c_l"/>
    <axis xyz="0 0 1"/>
    <limit effort="10" velocity="10"/>
  </joint>
  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
  <link name="carriage_link_carriage">
    <inertial>
      <origin xyz="-0.0185625 -0 0.00855063" rpy="0 0 0"/>
      <mass value="0.0209652"/>
      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
    </inertial>
    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
  </link>
  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
  <joint name="carriage_link_carriage_fixed" type="fixed">
    <origin xyz="0 0.01025 -0.0316282" rpy="1.5708 1.5708 0"/>
    <parent link="carriage_link"/>
    <child link="carriage_link_carriage"/>
    <axis xyz="0 0 1"/>
    <limit effort="10" velocity="10"/>
  </joint>
  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
  <link name="carriage_link_tr8_brass_flange_nut">
    <inertial>
      <origin xyz="-0.0105976 0 0.0103" rpy="0 0 0"/>
      <mass value="0.0117426"/>
      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
    </inertial>
    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
  </link>
  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
  <joint name="carriage_link_tr8_brass_flange_nut_fixed" type="fixed">
    <origin xyz="0 0.01025 -0.0316282" rpy="1.5708 1.5708 0"/>
    <parent link="carriage_link"/>
    <child link="carriage_link_tr8_brass_flange_nut"/>
    <axis xyz="0 0 1"/>
    <limit effort="10" velocity="10"/>
  </joint>
  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
  <link name="carriage_link_shoulder_screw_4x12_m3_c_u">
    <inertial>
      <origin xyz="-0.0162842 0.0249145 0.0141949" rpy="0 0 0"/>
      <mass value="0.00229081"/>
      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
    </inertial>
    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
  </link>
  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
  <joint name="carriage_link_shoulder_screw_4x12_m3_c_u_fixed" type="fixed">
    <origin xyz="0 0.01025 -0.0316282" rpy="1.5708 1.5708 0"/>
    <parent link="carriage_link"/>
    <child link="carriage_link_shoulder_screw_4x12_m3_c_u"/>
    <axis xyz="0 0 1"/>
    <limit effort="10" velocity="10"/>
  </joint>
  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
  <link name="carriage_link_socket_button_head_screw_m3x0_5_x_8__06a2044c27756322d8b45e7715e9afaa_13">
    <inertial>
      <origin xyz="0 0 0" rpy="0 0 0"/>
      <mass value="1e-09"/>
      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
    </inertial>
    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
  </link>
  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
  <joint name="carriage_link_socket_button_head_screw_m3x0_5_x_8__06a2044c27756322d8b45e7715e9afaa_13_fixed" type="fixed">
    <origin xyz="0.008 -5e-05 -0.026394" rpy="3.14159 -0 0"/>
    <parent link="carriage_link"/>
    <child link="carriage_link_socket_button_head_screw_m3x0_5_x_8__06a2044c27756322d8b45e7715e9afaa_13"/>
    <axis xyz="0 0 1"/>
    <limit effort="10" velocity="10"/>
  </joint>
  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
  <link name="carriage_link_socket_button_head_screw_m3x0_5_x_8__06a2044c27756322d8b45e7715e9afaa_14">
    <inertial>
      <origin xyz="0 0 0" rpy="0 0 0"/>
      <mass value="1e-09"/>
      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
    </inertial>
    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
  </link>
  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
  <joint name="carriage_link_socket_button_head_screw_m3x0_5_x_8__06a2044c27756322d8b45e7715e9afaa_14_fixed" type="fixed">
    <origin xyz="-0.008 -5e-05 -0.026394" rpy="3.14159 -0 0"/>
    <parent link="carriage_link"/>
    <child link="carriage_link_socket_button_head_screw_m3x0_5_x_8__06a2044c27756322d8b45e7715e9afaa_14"/>
    <axis xyz="0 0 1"/>
    <limit effort="10" velocity="10"/>
  </joint>
  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
  <joint name="carriage" type="prismatic">
    <origin xyz="-0.0162842 0 0.01025" rpy="-1.5708 -0 1.5708"/>
    <parent link="base_link"/>
    <child link="carriage_link"/>
    <axis xyz="0 0 1"/>
    <limit effort="50" velocity="0.1" lower="0" upper="0.0266"/>
  </joint>
  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
  <link name="base_link_socket_button_head_screw_m3x0_5_x_8__06a2044c27756322d8b45e7715e9afaa">
    <inertial>
      <origin xyz="0 0 0" rpy="0 0 0"/>
      <mass value="1e-09"/>
      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
    </inertial>
    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
  </link>
  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
  <joint name="base_link_socket_button_head_screw_m3x0_5_x_8__06a2044c27756322d8b45e7715e9afaa_fixed" type="fixed">
    <origin xyz="-0.0129904 -0.0584701 0.02795" rpy="0 -0 0"/>
    <parent link="base_link"/>
    <child link="base_link_socket_button_head_screw_m3x0_5_x_8__06a2044c27756322d8b45e7715e9afaa"/>
    <axis xyz="0 0 1"/>
    <limit effort="10" velocity="10"/>
  </joint>
  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
  <link name="base_link_dowel_4x38_5__40_cut__o2_l">
    <inertial>
      <origin xyz="0.0322712 -0.0210876 0.01025" rpy="0 0 0"/>
      <mass value="0.00379787"/>
      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
    </inertial>
    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
  </link>
  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
  <joint name="base_link_dowel_4x38_5__40_cut__o2_l_fixed" type="fixed">
    <origin xyz="0 0 0" rpy="0 -0 0"/>
    <parent link="base_link"/>
    <child link="base_link_dowel_4x38_5__40_cut__o2_l"/>
    <axis xyz="0 0 1"/>
    <limit effort="10" velocity="10"/>
  </joint>
  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
  <link name="base_link_magnet_6x2_5_diametric">
    <inertial>
      <origin xyz="0.02421 -0 0.0103" rpy="0 0 0"/>
      <mass value="0.000554884"/>
      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
    </inertial>
    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
  </link>
  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
  <joint name="base_link_magnet_6x2_5_diametric_fixed" type="fixed">
    <origin xyz="0 0 0" rpy="0 -0 0"/>
    <parent link="base_link"/>
    <child link="base_link_magnet_6x2_5_diametric"/>
    <axis xyz="0 0 1"/>
    <limit effort="10" velocity="10"/>
  </joint>
  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
  <link name="base_link_socket_button_head_screw_m3x0_5_x_8__06a2044c27756322d8b45e7715e9afaa_2">
    <inertial>
      <origin xyz="0 0 0" rpy="0 0 0"/>
      <mass value="1e-09"/>
      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
    </inertial>
    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
  </link>
  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
  <joint name="base_link_socket_button_head_screw_m3x0_5_x_8__06a2044c27756322d8b45e7715e9afaa_2_fixed" type="fixed">
    <origin xyz="-0.01 0.0375 0.03515" rpy="0 -0 0"/>
    <parent link="base_link"/>
    <child link="base_link_socket_button_head_screw_m3x0_5_x_8__06a2044c27756322d8b45e7715e9afaa_2"/>
    <axis xyz="0 0 1"/>
    <limit effort="10" velocity="10"/>
  </joint>
  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
  <link name="base_link_cover">
    <inertial>
      <origin xyz="-0.0208897 1.693e-09 0.0246373" rpy="0 0 0"/>
      <mass value="0.0939444"/>
      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
    </inertial>
    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
  </link>
  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
  <joint name="base_link_cover_fixed" type="fixed">
    <origin xyz="0 0 0" rpy="0 -0 0"/>
    <parent link="base_link"/>
    <child link="base_link_cover"/>
    <axis xyz="0 0 1"/>
    <limit effort="10" velocity="10"/>
  </joint>
  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
  <link name="base_link_socket_button_head_screw_m3x0_5_x_20__a36a91f17289e228f9f9bd0e86f10504">
    <inertial>
      <origin xyz="0 0 0" rpy="0 0 0"/>
      <mass value="1e-09"/>
      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
    </inertial>
    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
  </link>
  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
  <joint name="base_link_socket_button_head_screw_m3x0_5_x_20__a36a91f17289e228f9f9bd0e86f10504_fixed" type="fixed">
    <origin xyz="0.01606 -0.016 0.02795" rpy="0 -0 0"/>
    <parent link="base_link"/>
    <child link="base_link_socket_button_head_screw_m3x0_5_x_20__a36a91f17289e228f9f9bd0e86f10504"/>
    <axis xyz="0 0 1"/>
    <limit effort="10" velocity="10"/>
  </joint>
  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
  <link name="base_link_socket_button_head_screw_m3x0_5_x_8__06a2044c27756322d8b45e7715e9afaa_3">
    <inertial>
      <origin xyz="0 0 0" rpy="0 0 0"/>
      <mass value="1e-09"/>
      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
    </inertial>
    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
  </link>
  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
  <joint name="base_link_socket_button_head_screw_m3x0_5_x_8__06a2044c27756322d8b45e7715e9afaa_3_fixed" type="fixed">
    <origin xyz="-0.0984867 -0.02995 0.0165" rpy="1.5708 -0 0"/>
    <parent link="base_link"/>
    <child link="base_link_socket_button_head_screw_m3x0_5_x_8__06a2044c27756322d8b45e7715e9afaa_3"/>
    <axis xyz="0 0 1"/>
    <limit effort="10" velocity="10"/>
  </joint>
  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
  <link name="base_link_socket_button_head_screw_m3x0_5_x_20__a36a91f17289e228f9f9bd0e86f10504_2">
    <inertial>
      <origin xyz="0 0 0" rpy="0 0 0"/>
      <mass value="1e-09"/>
      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
    </inertial>
    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
  </link>
  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
  <joint name="base_link_socket_button_head_screw_m3x0_5_x_20__a36a91f17289e228f9f9bd0e86f10504_2_fixed" type="fixed">
    <origin xyz="-0.0464867 0.026 0.02795" rpy="0 -0 0"/>
    <parent link="base_link"/>
    <child link="base_link_socket_button_head_screw_m3x0_5_x_20__a36a91f17289e228f9f9bd0e86f10504_2"/>
    <axis xyz="0 0 1"/>
    <limit effort="10" velocity="10"/>
  </joint>
  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
  <link name="base_link_socket_button_head_screw_m3x0_5_x_8__06a2044c27756322d8b45e7715e9afaa_4">
    <inertial>
      <origin xyz="0 0 0" rpy="0 0 0"/>
      <mass value="1e-09"/>
      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
    </inertial>
    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
  </link>
  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
  <joint name="base_link_socket_button_head_screw_m3x0_5_x_8__06a2044c27756322d8b45e7715e9afaa_4_fixed" type="fixed">
    <origin xyz="-0.0443367 -0.0155 -0.0052" rpy="1.5708 -0 1.5708"/>
    <parent link="base_link"/>
    <child link="base_link_socket_button_head_screw_m3x0_5_x_8__06a2044c27756322d8b45e7715e9afaa_4"/>
    <axis xyz="0 0 1"/>
    <limit effort="10" velocity="10"/>
  </joint>
  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
  <link name="base_link_socket_button_head_screw_m3x0_5_x_8__06a2044c27756322d8b45e7715e9afaa_5">
    <inertial>
      <origin xyz="0 0 0" rpy="0 0 0"/>
      <mass value="1e-09"/>
      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
    </inertial>
    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
  </link>
  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
  <joint name="base_link_socket_button_head_screw_m3x0_5_x_8__06a2044c27756322d8b45e7715e9afaa_5_fixed" type="fixed">
    <origin xyz="-0.0984867 0.02995 0.004" rpy="-1.5708 -0 0"/>
    <parent link="base_link"/>
    <child link="base_link_socket_button_head_screw_m3x0_5_x_8__06a2044c27756322d8b45e7715e9afaa_5"/>
    <axis xyz="0 0 1"/>
    <limit effort="10" velocity="10"/>
  </joint>
  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
  <link name="base_link_bushing_4x6x6_o1_u">
    <inertial>
      <origin xyz="-0 0.0509701 0.0251" rpy="0 0 0"/>
      <mass value="0.000801106"/>
      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
    </inertial>
    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
  </link>
  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
  <joint name="base_link_bushing_4x6x6_o1_u_fixed" type="fixed">
    <origin xyz="0 0 0" rpy="0 -0 0"/>
    <parent link="base_link"/>
    <child link="base_link_bushing_4x6x6_o1_u"/>
    <axis xyz="0 0 1"/>
    <limit effort="10" velocity="10"/>
  </joint>
  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
  <link name="base_link_bushing_4x6x6_o2_u">
    <inertial>
      <origin xyz="0.0322712 0.0210876 0.0251" rpy="0 0 0"/>
      <mass value="0.000801106"/>
      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
    </inertial>
    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
  </link>
  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
  <joint name="base_link_bushing_4x6x6_o2_u_fixed" type="fixed">
    <origin xyz="0 0 0" rpy="0 -0 0"/>
    <parent link="base_link"/>
    <child link="base_link_bushing_4x6x6_o2_u"/>
    <axis xyz="0 0 1"/>
    <limit effort="10" velocity="10"/>
  </joint>
  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
  <link name="base_link_dowel_4x38_5__40_cut__o1_l">
    <inertial>
      <origin xyz="0 -0.0509701 0.01025" rpy="0 0 0"/>
      <mass value="0.00379787"/>
      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
    </inertial>
    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
  </link>
  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
  <joint name="base_link_dowel_4x38_5__40_cut__o1_l_fixed" type="fixed">
    <origin xyz="0 0 0" rpy="0 -0 0"/>
    <parent link="base_link"/>
    <child link="base_link_dowel_4x38_5__40_cut__o1_l"/>
    <axis xyz="0 0 1"/>
    <limit effort="10" velocity="10"/>
  </joint>
  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
  <link name="base_link_socket_button_head_screw_m3x0_5_x_10__ab5dc1006d13f2491c23b78383e7390f">
    <inertial>
      <origin xyz="0 0 0" rpy="0 0 0"/>
      <mass value="1e-09"/>
      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
    </inertial>
    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
  </link>
  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
  <joint name="base_link_socket_button_head_screw_m3x0_5_x_10__ab5dc1006d13f2491c23b78383e7390f_fixed" type="fixed">
    <origin xyz="0.021 -0.027 0.03675" rpy="0 -0 0"/>
    <parent link="base_link"/>
    <child link="base_link_socket_button_head_screw_m3x0_5_x_10__ab5dc1006d13f2491c23b78383e7390f"/>
    <axis xyz="0 0 1"/>
    <limit effort="10" velocity="10"/>
  </joint>
  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
  <link name="base_link_capacitor_100uf_35v">
    <inertial>
      <origin xyz="0.019 -0.0014 0.0411" rpy="0 0 0"/>
      <mass value="0.00111589"/>
      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
    </inertial>
    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
  </link>
  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
  <joint name="base_link_capacitor_100uf_35v_fixed" type="fixed">
    <origin xyz="0 0 0" rpy="0 -0 0"/>
    <parent link="base_link"/>
    <child link="base_link_capacitor_100uf_35v"/>
    <axis xyz="0 0 1"/>
    <limit effort="10" velocity="10"/>
  </joint>
  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
  <link name="base_link_bushing_4x6x6_o2_l">
    <inertial>
      <origin xyz="0.0322712 -0.0210876 0.0251" rpy="0 0 0"/>
      <mass value="0.000801106"/>
      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
    </inertial>
    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
  </link>
  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
  <joint name="base_link_bushing_4x6x6_o2_l_fixed" type="fixed">
    <origin xyz="0 0 0" rpy="0 -0 0"/>
    <parent link="base_link"/>
    <child link="base_link_bushing_4x6x6_o2_l"/>
    <axis xyz="0 0 1"/>
    <limit effort="10" velocity="10"/>
  </joint>
  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
  <link name="base_link_usb_c_pd_trigger_9v">
    <inertial>
      <origin xyz="0.007 -0.020997 0.0375322" rpy="0 0 0"/>
      <mass value="0.00109948"/>
      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
    </inertial>
    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
  </link>
  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
  <joint name="base_link_usb_c_pd_trigger_9v_fixed" type="fixed">
    <origin xyz="0 0 0" rpy="0 -0 0"/>
    <parent link="base_link"/>
    <child link="base_link_usb_c_pd_trigger_9v"/>
    <axis xyz="0 0 1"/>
    <limit effort="10" velocity="10"/>
  </joint>
  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
  <link name="base_link_socket_button_head_screw_m3x0_5_x_8__06a2044c27756322d8b45e7715e9afaa_6">
    <inertial>
      <origin xyz="0 0 0" rpy="0 0 0"/>
      <mass value="1e-09"/>
      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
    </inertial>
    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
  </link>
  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
  <joint name="base_link_socket_button_head_screw_m3x0_5_x_8__06a2044c27756322d8b45e7715e9afaa_6_fixed" type="fixed">
    <origin xyz="-0.0984867 0.02995 0.0165" rpy="-1.5708 -0 0"/>
    <parent link="base_link"/>
    <child link="base_link_socket_button_head_screw_m3x0_5_x_8__06a2044c27756322d8b45e7715e9afaa_6"/>
    <axis xyz="0 0 1"/>
    <limit effort="10" velocity="10"/>
  </joint>
  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
  <link name="base_link_tmc2209_driver">
    <inertial>
      <origin xyz="0.011611 0.0129531 0.0483842" rpy="0 0 0"/>
      <mass value="0.00166589"/>
      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
    </inertial>
    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
  </link>
  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
  <joint name="base_link_tmc2209_driver_fixed" type="fixed">
    <origin xyz="0 0 0" rpy="0 -0 0"/>
    <parent link="base_link"/>
    <child link="base_link_tmc2209_driver"/>
    <axis xyz="0 0 1"/>
    <limit effort="10" velocity="10"/>
  </joint>
  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
  <link name="base_link_base">
    <inertial>
      <origin xyz="-0.0200882 -2.768e-09 -0.00325098" rpy="0 0 0"/>
      <mass value="0.111462"/>
      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
    </inertial>
    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
  </link>
  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
  <joint name="base_link_base_fixed" type="fixed">
    <origin xyz="0 0 0" rpy="0 -0 0"/>
    <parent link="base_link"/>
    <child link="base_link_base"/>
    <axis xyz="0 0 1"/>
    <limit effort="10" velocity="10"/>
  </joint>
  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
  <link name="base_link_tr8x8_lead_screw__cut_73_0mm">
    <inertial>
      <origin xyz="-0.0129634 0 0.0103" rpy="0 0 0"/>
      <mass value="0.0280339"/>
      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
    </inertial>
    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
  </link>
  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
  <joint name="base_link_tr8x8_lead_screw__cut_73_0mm_fixed" type="fixed">
    <origin xyz="0 0 0" rpy="0 -0 0"/>
    <parent link="base_link"/>
    <child link="base_link_tr8x8_lead_screw__cut_73_0mm"/>
    <axis xyz="0 0 1"/>
    <limit effort="10" velocity="10"/>
  </joint>
  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
  <link name="base_link_locating_pin_m3x16_headless_l">
    <inertial>
      <origin xyz="0.01351 -0.011 0.0103" rpy="0 0 0"/>
      <mass value="0.000887814"/>
      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
    </inertial>
    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
  </link>
  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
  <joint name="base_link_locating_pin_m3x16_headless_l_fixed" type="fixed">
    <origin xyz="0 0 0" rpy="0 -0 0"/>
    <parent link="base_link"/>
    <child link="base_link_locating_pin_m3x16_headless_l"/>
    <axis xyz="0 0 1"/>
    <limit effort="10" velocity="10"/>
  </joint>
  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
  <link name="base_link_dowel_4x38_5__40_cut__o2_u">
    <inertial>
      <origin xyz="0.0322712 0.0210876 0.01025" rpy="0 0 0"/>
      <mass value="0.00379787"/>
      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
    </inertial>
    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
  </link>
  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
  <joint name="base_link_dowel_4x38_5__40_cut__o2_u_fixed" type="fixed">
    <origin xyz="0 0 0" rpy="0 -0 0"/>
    <parent link="base_link"/>
    <child link="base_link_dowel_4x38_5__40_cut__o2_u"/>
    <axis xyz="0 0 1"/>
    <limit effort="10" velocity="10"/>
  </joint>
  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
  <link name="base_link_bushing_4x6x6_o1_l">
    <inertial>
      <origin xyz="-0 -0.0509701 0.0251" rpy="0 0 0"/>
      <mass value="0.000801106"/>
      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
    </inertial>
    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
  </link>
  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
  <joint name="base_link_bushing_4x6x6_o1_l_fixed" type="fixed">
    <origin xyz="0 0 0" rpy="0 -0 0"/>
    <parent link="base_link"/>
    <child link="base_link_bushing_4x6x6_o1_l"/>
    <axis xyz="0 0 1"/>
    <limit effort="10" velocity="10"/>
  </joint>
  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
  <link name="base_link_header_sockets_pico_2x20">
    <inertial>
      <origin xyz="-0.00361 0 0.0406" rpy="0 0 0"/>
      <mass value="0.0026258"/>
      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
    </inertial>
    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
  </link>
  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
  <joint name="base_link_header_sockets_pico_2x20_fixed" type="fixed">
    <origin xyz="0 0 0" rpy="0 -0 0"/>
    <parent link="base_link"/>
    <child link="base_link_header_sockets_pico_2x20"/>
    <axis xyz="0 0 1"/>
    <limit effort="10" velocity="10"/>
  </joint>
  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
  <link name="base_link_protoboard_50x70">
    <inertial>
      <origin xyz="-4.80092e-05 0 0.0343" rpy="0 0 0"/>
      <mass value="0.00842958"/>
      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
    </inertial>
    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
  </link>
  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
  <joint name="base_link_protoboard_50x70_fixed" type="fixed">
    <origin xyz="0 0 0" rpy="0 -0 0"/>
    <parent link="base_link"/>
    <child link="base_link_protoboard_50x70"/>
    <axis xyz="0 0 1"/>
    <limit effort="10" velocity="10"/>
  </joint>
  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
  <link name="base_link_encoder_magnet_puck">
    <inertial>
      <origin xyz="0.0237985 0 0.0103" rpy="0 0 0"/>
      <mass value="7.18502e-05"/>
      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
    </inertial>
    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
  </link>
  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
  <joint name="base_link_encoder_magnet_puck_fixed" type="fixed">
    <origin xyz="0 0 0" rpy="0 -0 0"/>
    <parent link="base_link"/>
    <child link="base_link_encoder_magnet_puck"/>
    <axis xyz="0 0 1"/>
    <limit effort="10" velocity="10"/>
  </joint>
  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
  <link name="base_link_socket_button_head_screw_m3x0_5_x_8__06a2044c27756322d8b45e7715e9afaa_7">
    <inertial>
      <origin xyz="0 0 0" rpy="0 0 0"/>
      <mass value="1e-09"/>
      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
    </inertial>
    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
  </link>
  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
  <joint name="base_link_socket_button_head_screw_m3x0_5_x_8__06a2044c27756322d8b45e7715e9afaa_7_fixed" type="fixed">
    <origin xyz="-0.0443367 0.0155 0.0258" rpy="1.5708 -0 1.5708"/>
    <parent link="base_link"/>
    <child link="base_link_socket_button_head_screw_m3x0_5_x_8__06a2044c27756322d8b45e7715e9afaa_7"/>
    <axis xyz="0 0 1"/>
    <limit effort="10" velocity="10"/>
  </joint>
  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
  <link name="base_link_lock_collar_8x14x7__thrust">
    <inertial>
      <origin xyz="0.01506 0 0.0103" rpy="0 0 0"/>
      <mass value="0.00569681"/>
      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
    </inertial>
    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
  </link>
  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
  <joint name="base_link_lock_collar_8x14x7__thrust_fixed" type="fixed">
    <origin xyz="0 0 0" rpy="0 -0 0"/>
    <parent link="base_link"/>
    <child link="base_link_lock_collar_8x14x7__thrust"/>
    <axis xyz="0 0 1"/>
    <limit effort="10" velocity="10"/>
  </joint>
  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
  <link name="base_link_socket_button_head_screw_m3x0_5_x_10__ab5dc1006d13f2491c23b78383e7390f_2">
    <inertial>
      <origin xyz="0 0 0" rpy="0 0 0"/>
      <mass value="1e-09"/>
      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
    </inertial>
    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
  </link>
  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
  <joint name="base_link_socket_button_head_screw_m3x0_5_x_10__ab5dc1006d13f2491c23b78383e7390f_2_fixed" type="fixed">
    <origin xyz="-0.0125 -0.027 0.03675" rpy="0 -0 0"/>
    <parent link="base_link"/>
    <child link="base_link_socket_button_head_screw_m3x0_5_x_10__ab5dc1006d13f2491c23b78383e7390f_2"/>
    <axis xyz="0 0 1"/>
    <limit effort="10" velocity="10"/>
  </joint>
  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
  <link name="base_link_socket_button_head_screw_m3x0_5_x_20__a36a91f17289e228f9f9bd0e86f10504_3">
    <inertial>
      <origin xyz="0 0 0" rpy="0 0 0"/>
      <mass value="1e-09"/>
      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
    </inertial>
    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
  </link>
  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
  <joint name="base_link_socket_button_head_screw_m3x0_5_x_20__a36a91f17289e228f9f9bd0e86f10504_3_fixed" type="fixed">
    <origin xyz="0.01606 0.016 0.02795" rpy="0 -0 0"/>
    <parent link="base_link"/>
    <child link="base_link_socket_button_head_screw_m3x0_5_x_20__a36a91f17289e228f9f9bd0e86f10504_3"/>
    <axis xyz="0 0 1"/>
    <limit effort="10" velocity="10"/>
  </joint>
  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
  <link name="base_link_regulator_7805_to_220">
    <inertial>
      <origin xyz="0.0189 -0.0132264 0.0380258" rpy="0 0 0"/>
      <mass value="0.000957437"/>
      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
    </inertial>
    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
  </link>
  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
  <joint name="base_link_regulator_7805_to_220_fixed" type="fixed">
    <origin xyz="0 0 0" rpy="0 -0 0"/>
    <parent link="base_link"/>
    <child link="base_link_regulator_7805_to_220"/>
    <axis xyz="0 0 1"/>
    <limit effort="10" velocity="10"/>
  </joint>
  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
  <link name="base_link_socket_button_head_screw_m3x0_5_x_8__06a2044c27756322d8b45e7715e9afaa_8">
    <inertial>
      <origin xyz="0 0 0" rpy="0 0 0"/>
      <mass value="1e-09"/>
      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
    </inertial>
    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
  </link>
  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
  <joint name="base_link_socket_button_head_screw_m3x0_5_x_8__06a2044c27756322d8b45e7715e9afaa_8_fixed" type="fixed">
    <origin xyz="-0.0129904 0.0584701 0.02795" rpy="0 -0 0"/>
    <parent link="base_link"/>
    <child link="base_link_socket_button_head_screw_m3x0_5_x_8__06a2044c27756322d8b45e7715e9afaa_8"/>
    <axis xyz="0 0 1"/>
    <limit effort="10" velocity="10"/>
  </joint>
  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
  <link name="base_link_as5600_encoder_board">
    <inertial>
      <origin xyz="0.0287122 0 0.0103" rpy="0 0 0"/>
      <mass value="0.00166296"/>
      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
    </inertial>
    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
  </link>
  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
  <joint name="base_link_as5600_encoder_board_fixed" type="fixed">
    <origin xyz="0 0 0" rpy="0 -0 0"/>
    <parent link="base_link"/>
    <child link="base_link_as5600_encoder_board"/>
    <axis xyz="0 0 1"/>
    <limit effort="10" velocity="10"/>
  </joint>
  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
  <link name="base_link_socket_button_head_screw_m3x0_5_x_20__a36a91f17289e228f9f9bd0e86f10504_4">
    <inertial>
      <origin xyz="0 0 0" rpy="0 0 0"/>
      <mass value="1e-09"/>
      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
    </inertial>
    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
  </link>
  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
  <joint name="base_link_socket_button_head_screw_m3x0_5_x_20__a36a91f17289e228f9f9bd0e86f10504_4_fixed" type="fixed">
    <origin xyz="-0.0464867 -0.026 0.02795" rpy="0 -0 0"/>
    <parent link="base_link"/>
    <child link="base_link_socket_button_head_screw_m3x0_5_x_20__a36a91f17289e228f9f9bd0e86f10504_4"/>
    <axis xyz="0 0 1"/>
    <limit effort="10" velocity="10"/>
  </joint>
  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
  <link name="base_link_header_sockets_pico_2x20_2">
    <inertial>
      <origin xyz="-0.02139 0 0.0406" rpy="0 0 0"/>
      <mass value="0.0026258"/>
      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
    </inertial>
    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
  </link>
  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
  <joint name="base_link_header_sockets_pico_2x20_2_fixed" type="fixed">
    <origin xyz="0 0 0" rpy="0 -0 0"/>
    <parent link="base_link"/>
    <child link="base_link_header_sockets_pico_2x20_2"/>
    <axis xyz="0 0 1"/>
    <limit effort="10" velocity="10"/>
  </joint>
  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
  <link name="base_link_socket_button_head_screw_m3x0_5_x_8__06a2044c27756322d8b45e7715e9afaa_9">
    <inertial>
      <origin xyz="0 0 0" rpy="0 0 0"/>
      <mass value="1e-09"/>
      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
    </inertial>
    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
  </link>
  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
  <joint name="base_link_socket_button_head_screw_m3x0_5_x_8__06a2044c27756322d8b45e7715e9afaa_9_fixed" type="fixed">
    <origin xyz="-0.0984867 -0.02995 0.004" rpy="1.5708 -0 0"/>
    <parent link="base_link"/>
    <child link="base_link_socket_button_head_screw_m3x0_5_x_8__06a2044c27756322d8b45e7715e9afaa_9"/>
    <axis xyz="0 0 1"/>
    <limit effort="10" velocity="10"/>
  </joint>
  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
  <link name="base_link_nema17_stepper_yejmkj_42x38_7">
    <inertial>
      <origin xyz="-0.0696345 0 0.0103" rpy="0 0 0"/>
      <mass value="0.536471"/>
      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
    </inertial>
    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
  </link>
  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
  <joint name="base_link_nema17_stepper_yejmkj_42x38_7_fixed" type="fixed">
    <origin xyz="0 0 0" rpy="0 -0 0"/>
    <parent link="base_link"/>
    <child link="base_link_nema17_stepper_yejmkj_42x38_7"/>
    <axis xyz="0 0 1"/>
    <limit effort="10" velocity="10"/>
  </joint>
  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
  <link name="base_link_socket_button_head_screw_m3x0_5_x_10__ab5dc1006d13f2491c23b78383e7390f_3">
    <inertial>
      <origin xyz="0 0 0" rpy="0 0 0"/>
      <mass value="1e-09"/>
      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
    </inertial>
    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
  </link>
  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
  <joint name="base_link_socket_button_head_screw_m3x0_5_x_10__ab5dc1006d13f2491c23b78383e7390f_3_fixed" type="fixed">
    <origin xyz="0.021 0.027 0.03675" rpy="0 -0 0"/>
    <parent link="base_link"/>
    <child link="base_link_socket_button_head_screw_m3x0_5_x_10__ab5dc1006d13f2491c23b78383e7390f_3"/>
    <axis xyz="0 0 1"/>
    <limit effort="10" velocity="10"/>
  </joint>
  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
  <link name="base_link_electronics_cover">
    <inertial>
      <origin xyz="0.000424398 0.00242329 0.0463002" rpy="0 0 0"/>
      <mass value="0.01728"/>
      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
    </inertial>
    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
  </link>
  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
  <joint name="base_link_electronics_cover_fixed" type="fixed">
    <origin xyz="0 0 0" rpy="0 -0 0"/>
    <parent link="base_link"/>
    <child link="base_link_electronics_cover"/>
    <axis xyz="0 0 1"/>
    <limit effort="10" velocity="10"/>
  </joint>
  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
  <link name="base_link_header_sockets_driver_2x8">
    <inertial>
      <origin xyz="0.01797 0.01316 0.0406" rpy="0 0 0"/>
      <mass value="0.00105032"/>
      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
    </inertial>
    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
  </link>
  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
  <joint name="base_link_header_sockets_driver_2x8_fixed" type="fixed">
    <origin xyz="0 0 0" rpy="0 -0 0"/>
    <parent link="base_link"/>
    <child link="base_link_header_sockets_driver_2x8"/>
    <axis xyz="0 0 1"/>
    <limit effort="10" velocity="10"/>
  </joint>
  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
  <link name="base_link_controller_spacer_front_u">
    <inertial>
      <origin xyz="0.021 0.027 0.0315" rpy="0 0 0"/>
      <mass value="6.1065e-05"/>
      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
    </inertial>
    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
  </link>
  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
  <joint name="base_link_controller_spacer_front_u_fixed" type="fixed">
    <origin xyz="0 0 0" rpy="0 -0 0"/>
    <parent link="base_link"/>
    <child link="base_link_controller_spacer_front_u"/>
    <axis xyz="0 0 1"/>
    <limit effort="10" velocity="10"/>
  </joint>
  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
  <link name="base_link_controller_spacer_front_l">
    <inertial>
      <origin xyz="0.021 -0.027 0.0315" rpy="0 0 0"/>
      <mass value="6.1065e-05"/>
      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
    </inertial>
    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
  </link>
  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
  <joint name="base_link_controller_spacer_front_l_fixed" type="fixed">
    <origin xyz="0 0 0" rpy="0 -0 0"/>
    <parent link="base_link"/>
    <child link="base_link_controller_spacer_front_l"/>
    <axis xyz="0 0 1"/>
    <limit effort="10" velocity="10"/>
  </joint>
  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
  <link name="base_link_adapter_iso9409_50">
    <inertial>
      <origin xyz="-0.0991224 0 0.0101849" rpy="0 0 0"/>
      <mass value="0.0394638"/>
      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
    </inertial>
    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
  </link>
  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
  <joint name="base_link_adapter_iso9409_50_fixed" type="fixed">
    <origin xyz="0 0 0" rpy="0 -0 0"/>
    <parent link="base_link"/>
    <child link="base_link_adapter_iso9409_50"/>
    <axis xyz="0 0 1"/>
    <limit effort="10" velocity="10"/>
  </joint>
  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
  <link name="base_link_608zz_bearing">
    <inertial>
      <origin xyz="0.02206 0 0.0103" rpy="0 0 0"/>
      <mass value="0.0181262"/>
      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
    </inertial>
    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
  </link>
  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
  <joint name="base_link_608zz_bearing_fixed" type="fixed">
    <origin xyz="0 0 0" rpy="0 -0 0"/>
    <parent link="base_link"/>
    <child link="base_link_608zz_bearing"/>
    <axis xyz="0 0 1"/>
    <limit effort="10" velocity="10"/>
  </joint>
  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
  <link name="base_link_header_sockets_driver_2x8_2">
    <inertial>
      <origin xyz="0.00527 0.01316 0.0406" rpy="0 0 0"/>
      <mass value="0.00105032"/>
      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
    </inertial>
    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
  </link>
  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
  <joint name="base_link_header_sockets_driver_2x8_2_fixed" type="fixed">
    <origin xyz="0 0 0" rpy="0 -0 0"/>
    <parent link="base_link"/>
    <child link="base_link_header_sockets_driver_2x8_2"/>
    <axis xyz="0 0 1"/>
    <limit effort="10" velocity="10"/>
  </joint>
  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
  <link name="base_link_socket_button_head_screw_m3x0_5_x_10__ab5dc1006d13f2491c23b78383e7390f_4">
    <inertial>
      <origin xyz="0 0 0" rpy="0 0 0"/>
      <mass value="1e-09"/>
      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
    </inertial>
    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
  </link>
  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
  <joint name="base_link_socket_button_head_screw_m3x0_5_x_10__ab5dc1006d13f2491c23b78383e7390f_4_fixed" type="fixed">
    <origin xyz="-0.0125 0.027 0.03675" rpy="0 -0 0"/>
    <parent link="base_link"/>
    <child link="base_link_socket_button_head_screw_m3x0_5_x_10__ab5dc1006d13f2491c23b78383e7390f_4"/>
    <axis xyz="0 0 1"/>
    <limit effort="10" velocity="10"/>
  </joint>
  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
  <link name="base_link_socket_button_head_screw_m3x0_5_x_8__06a2044c27756322d8b45e7715e9afaa_10">
    <inertial>
      <origin xyz="0 0 0" rpy="0 0 0"/>
      <mass value="1e-09"/>
      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
    </inertial>
    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
  </link>
  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
  <joint name="base_link_socket_button_head_screw_m3x0_5_x_8__06a2044c27756322d8b45e7715e9afaa_10_fixed" type="fixed">
    <origin xyz="-0.01 -0.0375 0.03515" rpy="0 -0 0"/>
    <parent link="base_link"/>
    <child link="base_link_socket_button_head_screw_m3x0_5_x_8__06a2044c27756322d8b45e7715e9afaa_10"/>
    <axis xyz="0 0 1"/>
    <limit effort="10" velocity="10"/>
  </joint>
  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
  <link name="base_link_locating_pin_m3x16_headless_u">
    <inertial>
      <origin xyz="0.01351 0.011 0.0103" rpy="0 0 0"/>
      <mass value="0.000887814"/>
      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
    </inertial>
    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
  </link>
  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
  <joint name="base_link_locating_pin_m3x16_headless_u_fixed" type="fixed">
    <origin xyz="0 0 0" rpy="0 -0 0"/>
    <parent link="base_link"/>
    <child link="base_link_locating_pin_m3x16_headless_u"/>
    <axis xyz="0 0 1"/>
    <limit effort="10" velocity="10"/>
  </joint>
  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
  <link name="base_link_socket_button_head_screw_m3x0_5_x_8__06a2044c27756322d8b45e7715e9afaa_11">
    <inertial>
      <origin xyz="0 0 0" rpy="0 0 0"/>
      <mass value="1e-09"/>
      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
    </inertial>
    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
  </link>
  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
  <joint name="base_link_socket_button_head_screw_m3x0_5_x_8__06a2044c27756322d8b45e7715e9afaa_11_fixed" type="fixed">
    <origin xyz="-0.0443367 0.0155 -0.0052" rpy="1.5708 -0 1.5708"/>
    <parent link="base_link"/>
    <child link="base_link_socket_button_head_screw_m3x0_5_x_8__06a2044c27756322d8b45e7715e9afaa_11"/>
    <axis xyz="0 0 1"/>
    <limit effort="10" velocity="10"/>
  </joint>
  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
  <link name="base_link_socket_button_head_screw_m3x0_5_x_8__06a2044c27756322d8b45e7715e9afaa_12">
    <inertial>
      <origin xyz="0 0 0" rpy="0 0 0"/>
      <mass value="1e-09"/>
      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
    </inertial>
    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
  </link>
  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
  <joint name="base_link_socket_button_head_screw_m3x0_5_x_8__06a2044c27756322d8b45e7715e9afaa_12_fixed" type="fixed">
    <origin xyz="-0.0443367 -0.0155 0.0258" rpy="1.5708 -0 1.5708"/>
    <parent link="base_link"/>
    <child link="base_link_socket_button_head_screw_m3x0_5_x_8__06a2044c27756322d8b45e7715e9afaa_12"/>
    <axis xyz="0 0 1"/>
    <limit effort="10" velocity="10"/>
  </joint>
  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
  <link name="base_link_controller_spacer_rear_u">
    <inertial>
      <origin xyz="-0.0125 0.027 0.0315" rpy="0 0 0"/>
      <mass value="6.1065e-05"/>
      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
    </inertial>
    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
  </link>
  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
  <joint name="base_link_controller_spacer_rear_u_fixed" type="fixed">
    <origin xyz="0 0 0" rpy="0 -0 0"/>
    <parent link="base_link"/>
    <child link="base_link_controller_spacer_rear_u"/>
    <axis xyz="0 0 1"/>
    <limit effort="10" velocity="10"/>
  </joint>
  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
  <link name="base_link_controller_spacer_rear_l">
    <inertial>
      <origin xyz="-0.0125 -0.027 0.0315" rpy="0 0 0"/>
      <mass value="6.1065e-05"/>
      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
    </inertial>
    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
  </link>
  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
  <joint name="base_link_controller_spacer_rear_l_fixed" type="fixed">
    <origin xyz="0 0 0" rpy="0 -0 0"/>
    <parent link="base_link"/>
    <child link="base_link_controller_spacer_rear_l"/>
    <axis xyz="0 0 1"/>
    <limit effort="10" velocity="10"/>
  </joint>
  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
  <link name="base_link_dowel_4x38_5__40_cut__o1_u">
    <inertial>
      <origin xyz="0 0.0509701 0.01025" rpy="0 0 0"/>
      <mass value="0.00379787"/>
      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
    </inertial>
    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
  </link>
  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
  <joint name="base_link_dowel_4x38_5__40_cut__o1_u_fixed" type="fixed">
    <origin xyz="0 0 0" rpy="0 -0 0"/>
    <parent link="base_link"/>
    <child link="base_link_dowel_4x38_5__40_cut__o1_u"/>
    <axis xyz="0 0 1"/>
    <limit effort="10" velocity="10"/>
  </joint>
  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
  <link name="base_link_pico_ref_usb_step__none">
    <inertial>
      <origin xyz="0 0 0" rpy="0 0 0"/>
      <mass value="1e-09"/>
      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
    </inertial>
    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
  </link>
  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
  <joint name="base_link_pico_ref_usb_step__none_fixed" type="fixed">
    <origin xyz="-0.002 0.0255 0.0466" rpy="1.5708 -0 3.14159"/>
    <parent link="base_link"/>
    <child link="base_link_pico_ref_usb_step__none"/>
    <axis xyz="0 0 1"/>
    <limit effort="10" velocity="10"/>
  </joint>
  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
  <link name="base_link_pico_ref_usb_step__none_2">
    <inertial>
      <origin xyz="0 0 0" rpy="0 0 0"/>
      <mass value="1e-09"/>
      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
    </inertial>
    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
  </link>
  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
  <joint name="base_link_pico_ref_usb_step__none_2_fixed" type="fixed">
    <origin xyz="-0.002 0.0255 0.0466" rpy="1.5708 -0 3.14159"/>
    <parent link="base_link"/>
    <child link="base_link_pico_ref_usb_step__none_2"/>
    <axis xyz="0 0 1"/>
    <limit effort="10" velocity="10"/>
  </joint>
  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
  <link name="base_link_pico_ref_board_step__none">
    <inertial>
      <origin xyz="0 0 0" rpy="0 0 0"/>
      <mass value="1e-09"/>
      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
    </inertial>
    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
  </link>
  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
  <joint name="base_link_pico_ref_board_step__none_fixed" type="fixed">
    <origin xyz="-0.002 0.0255 0.0466" rpy="1.5708 -0 3.14159"/>
    <parent link="base_link"/>
    <child link="base_link_pico_ref_board_step__none"/>
    <axis xyz="0 0 1"/>
    <limit effort="10" velocity="10"/>
  </joint>
  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
  <link name="base_link_pico_winbond_step__none">
    <inertial>
      <origin xyz="0 0 0" rpy="0 0 0"/>
      <mass value="1e-09"/>
      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
    </inertial>
    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
  </link>
  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
  <joint name="base_link_pico_winbond_step__none_fixed" type="fixed">
    <origin xyz="-0.002 0.0255 0.0466" rpy="1.5708 -0 3.14159"/>
    <parent link="base_link"/>
    <child link="base_link_pico_winbond_step__none"/>
    <axis xyz="0 0 1"/>
    <limit effort="10" velocity="10"/>
  </joint>
  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
    <child link="base_link_pico_murata_step__none_1"/>
    <axis xyz="0 0 1"/>
    <limit effort="10" velocity="10"/>
  </joint>
  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
  <link name="base_link_pico_richtek_step__none">
    <inertial>
      <origin xyz="0 0 0" rpy="0 0 0"/>
      <mass value="1e-09"/>
      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
    </inertial>
    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
  </link>
  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
  <joint name="base_link_pico_richtek_step__none_fixed" type="fixed">
    <origin xyz="-0.002 0.0255 0.0466" rpy="1.5708 -0 3.14159"/>
    <parent link="base_link"/>
    <child link="base_link_pico_richtek_step__none"/>
    <axis xyz="0 0 1"/>
    <limit effort="10" velocity="10"/>
  </joint>
  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
  <link name="base_link_pico_ref_usb_step__none_5">
    <inertial>
      <origin xyz="0 0 0" rpy="0 0 0"/>
      <mass value="1e-09"/>
      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
    </inertial>
    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
  </link>
  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
  <joint name="base_link_pico_ref_usb_step__none_5_fixed" type="fixed">
    <origin xyz="-0.002 0.0255 0.0466" rpy="1.5708 -0 3.14159"/>
    <parent link="base_link"/>
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
