anuragbhandari-eng/Gripper_V2/gripper_fabrication_rev7/firmware/main.py

# Optional: save this on the Pico as main.py to start the stand-alone demo whenever it powers up.
# Press BOOTSEL to grip or release. Thonny stops it when you connect; delete main.py from the Pico to turn it off.
import bench
bench.demo()
