anuragbhandari-eng/Gripper_V2/(commit log)

2026-10-24 Add rev 6 baseline docs, BOM and print list
    [BOM.csv]
2026-10-24 Handoff: put the v2 design in a new Onshape document named GripperV2
2026-10-24 Handoff: record v2 decisions and GripperV2 ids
    - GripperV2 created in Onshape as a copy of the original; ids recorded
    - Printed parts switch to ABS; list what rev 7 must update
    - Pads: printed TPU 95A. Power: 3S LiPo + balance charger. Load cell dropped
    - Bench stand (new item F); step order updated; parts list for Amazon US
2026-10-24 Rev 7 step 1: copy rev 6 source and reproduce its results
    - gripper_fabrication_rev7/source is a copy of rev6/source
    - Full pipeline re-run in rev7: 49 valid parts, 0 collisions over 41 poses,
    min SF 3.6; .fs, volumes, BOM, print list and report identical to rev 6
    - results.json differs only in the last float digits (newer numpy);
    plots and renders differ only in font and shading
    [BOM.csv]
2026-10-24 Rev 7 step 2: switch printed parts from PETG to ABS
    - Material in one place: design.py MAT, MAT_SY (30 MPa in-plane),
    MAT_SZ (12 MPa across layers), MAT_RHO (1.04 g/cm3); generic ABS,
    since the fablab spool brand is unknown
    - structural, fasteners, export, fit_coupons, fs_gen and make_docs read it
    - Structural min SF 3.6 -> 2.9 (finger bore F2, jaw root); fasteners
    4.3 -> 3.0; mass 763 -> 695 g; geometry checks unchanged
    - M3 tightening limit 0.2 -> 0.15 N·m; ABS print settings in the report
    [BOM.csv]
2026-10-24 Rev 7 step 3 (B): bolt-on tip blocks, two sets, TPU pads
    - Finger split at x = 41: finger body keeps a 20 mm tongue; tip block slides
    up onto it and takes 2x M3x16 from the top into inserts in the tongue
    - Narrow set (pad face on the rev 6 line, gap 0-66) and wide set (+10 mm per
    side, 20-86), both 12 mm longer; same TPU 95A pad with a dovetail key
    - Heel trimmed to 1.5 mm behind the wide pad face; back edge now F1-F2,
    O2-spacer clearance 1.18 -> 1.90 mm
    - FeatureScript: "Tip set" dialog option, wide geometry per spec (opsW),
    pad-to-pad gap readout; new specs appended at the end
    - Pin loads now take the worst grip point on the pad (heel to far tip);
    seam, tongue and tip-screw check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
    [BOM.csv]
2026-10-24 Rev 7 steps 4-6 (C, D, F): encoder, controller mount, bench stand
    C - AS5600 at the screw's front end: screw cut 3 mm shorter (78.5 mm);
    printed puck with a 6x2.5 diametric magnet fills the end of the 608
    bore; the 23 mm board stands across the block front in a slot split
    between base and cover; chip window keeps the lip on the 608 outer
    ring (shear-out SF 9.0); wire slit up through the cover. Block bolts
    moved to rear ears because the board spans the old bolt positions.
    D - 50x70 protoboard (Pico, TMC2209, 5 V buck, battery divider) on 4 M3
    standoffs into heat-set inserts in the cover top.
    F - Bench stand, jaws down: printed head bracket on the ISO 9409 adapter
    (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
    [BOM.csv]
2026-10-24 Rev 7 step 7 (A): Tr8x2 -> Tr8x8 drive, report update
    - LEAD = 8 mm (4-start): 4.0 turns over the stroke, 400 steps/mm at 1/16,
    600 rpm -> 80 mm/s, full stroke 0.4 s; not self-locking
    - Driver current now chosen by structural.py: 0.70 A RMS gives the 25 N
    grip target with worst-case friction; stall 78-110 N (rev 6: 96-175 N)
    - Report: rev 7 section with wiring table, summary rows, BOM (electronics,
    power, stand hardware), assembly sequence, limits (wide-set F2 boss,
    AS5600 board size)
    [BOM.csv]
2026-10-24 Rev 7 step 8: GripperV2 in Onshape updated and verified
    - Feature Studio 1 replaced with the rev 7 FeatureScript through the
    browser session (read back identical, SHA-256 f8f3a1e48e7280c4;
    0 FeatureScript MCP requests)
    - Part Studio 1: 72 parts, all volumes within 1.3 mm3 of local; wide set
    checked and matched, dialog left on Narrow
    - Assembly 1: 23 new instances; rigid groups "Finger U + tip" and
    "Finger L + tip"; encoder, controller and stand parts added to
    "Frame (fixed)"; 21/21 features OK; slider verified at both limits
    - Record in source/results_onshape_rev7.json; Onshape shaded views in
    images/; report section 7 and the handoff status updated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
    [make_docs.py]
2026-10-24 Model the header strips under the controller modules
    The Pico and buck sat 2.5 mm and the TMC2209 8.5 mm above the protoboard
    (their real heights on pin headers and sockets) with nothing in between,
    so they looked like they were floating. Each module now includes its
    header strips (Pico 2x20 male, TMC2209 2x8 female, buck 2x2 pins), resting
    on the board. Same Onshape part ids; GripperV2 Feature Studio updated
    (SHA-256 05ef67f130b2d4b1), volumes match local, Assembly 1 21/21 OK.
    0 collisions over 41 poses.
    [design.py]
2026-10-25 Review items 1-2: rebuild the tip joint and centre the pad on the pin plane
    - Tip block and pad now z 0.55-20.05, centred on the pin plane (z 10.3):
    a normal grip no longer twists the finger
    - Tongue rises from the finger body to the block top (13.55 mm) and runs
    2.8 mm under the outer edge: root section 16.3 x 13.6 mm (was 9 x 7.6)
    - Block slides up onto the tongue (pocket open at top and rear, floor
    below); 2x M3x10 from below into inserts at the tongue's mid-depth;
    block prints flat, floor down
    - structural.py: tongue root bending (SF 1.6 limit / 5.3 in use; was
    0.27 / 0.89), flank bearing 2.7, torsion and F2-bore twist for a grip
    on the pad edge (bore-only model: 0.6 limit /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
    [BOM.csv]
2026-10-25 Review item 3: fixed pivots held at both ends by bonded bronze sleeves
    - Each dowel top now runs in a 4x6x6 bronze sleeve bonded with epoxy into
    an oversize cover hole (0.2 mm gap) while the cover sits on the dowels:
    zero clearance however the printed parts shrink, no reamer needed;
    wax on the dowel tops keeps the cover removable
    - Dowels 4x32 -> 4x36 (6.5 mm in the base, flush with the cover top)
    - Checks: base socket SF 2.6, cover via sleeve 4.5 (was 1.9 on a 3.9 mm
    reamed hole), dowel bending 2.0 at the 200 N limit
    - BOM, assembly steps and report text updated; 76 parts, 0 collisions
    for both tip sets
    [BOM.csv]
2026-10-25 Review item 4: pads snap into place and can't slide back out
    - Groove entrance (the first 4.4 mm from the rear) is 1.1 mm deep, the
    rest 1.5 mm; the pad key is 1.05 mm deep except a 3 mm full-depth barb
    at its rear end, which squeezes through the entrance (TPU 95A) and then
    catches on the step
    - Checked: no overlap when installed; pulled back 1 mm, the barb hits the
    step (both sets)
    - 76 parts, 0 collisions for both tip sets
    [BOM.csv]
2026-10-25 Review items 7-8: battery off the work zone, stand fixed to the bench
    - Battery Velcro-strapped to the column's far face at mid-height: >= 45 mm
    from every gripper part (was 8.9 mm from the wide tip, under a jaw);
    the base tray and strap slots are gone
    - Power path: fuse ahead of the switch, battery divider after the switch,
    balance-lead low-voltage alarm; switch off after use
    - Stand base 150x150 -> 180x170 with 4 counterbored holes to bolt or screw
    it to the bench (unclamped it still tips at about 5 N at gripper height);
    2 M5 through the socket walls into T-nuts stop the column wobbling;
    stand M5 screws 10 -> 12 mm
    - 76 parts, 0 collisions for both tip sets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
    [BOM.csv]
2026-10-25 Review item 12: locating pins across the bearing-block split
    - 2x Ø3x16 dowels at (X_BLK0 + 2.45, ±11) register the base and cover
    halves of the bearing block, so the split 608 seat and the motor pilot
    no longer depend only on the 4 distant pivot dowels (ABS warp risk);
    press in the base half, slip in the cover
    - Report: check base, cover and stand base for flatness before assembly
    - 78 parts, 0 collisions for both tip sets
    [BOM.csv]
2026-10-25 Review item 11: fit coupons for the rev 7 fits
    - 13b_FitTest_rev7 (ABS, 23 cm3), cut straight from the real parts: tongue
    stub and narrow tip-block pocket stub (inserts, slide fit, M3x10 floor
    screws, pad groove and snap step), AS5600 slot half, M6 nut pocket,
    2020 column socket, magnet puck (try it in a 608)
    - 13c_FitTest_pad_TPU95A: pad stub with the snap barb
    - Bore gauge gains the Ø3 locating-pin press and slip holes
    - Report: print these first; gripper geometry unchanged
    [BOM.csv]
2026-10-25 Review items 5, 6, 9, 10: drive safety, homing, grip schedule, encoder test
    - 5: hard-stop estimate in structural.py (rotor 54 g cm2 assumed -> 3.3 kg
    at the carriage; 146-462 N at 600 rpm, 18-58 N at 10 mm/s); homing at
    0.3 A and 10 mm/s with the stop detected by the AS5600, slow in the
    last 2 mm; check the motor's axial rating
    - 6: driver current ceiling set by the VREF pot with i_scale_analog, 10 k
    EN pull-up, firmware re-sends the config after a driver reset
    - 9: run-current table against the gap for about 30 N per jaw
    (0.70 A at small gaps down to 0.36 A at 60 mm), IRUN values included
    - 10: encoder bench test (608 + puck + AS5600: AGC, magnitude, linearity)
    before printing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
    [BOM.csv]
2026-10-25 GripperV2 updated to rev 7.1 and verified; review status recorded
    - Feature Studio rev 7.1 (SHA-256 f29064932af61cb0); Part Studio 78 parts
    within 1.22 mm3 of local; wide set matches; Assembly 1: 4 bronze sleeves
    and 2 block pins inserted into "Frame (fixed)", 21/21 features OK,
    motion verified at both limits, slider left at 0
    - Onshape evCollision over all bodies: only the intended press fits
    - fs_gen: the rev 7.1 specs now come after the stand specs (putting them
    before shifted the stand part ids and broke 4 instances; fixed)
    - Onshape record, pictures, handoff resume point and the review status
    table (items 1-12) updated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
    [fs_gen.py]
2026-10-25 Desk clamps for the bench stand (40 x 40 mm desk edge)
    - 2 printed C-clamps hook over the base's front corners: the upper arm
    sits on the base with a boss in the corner counterbore, the spine runs
    down in front of the desk edge, and an M8 star knob in a captive nut
    pushes a printed pad up under the 40 mm black edge, 20 mm behind its
    front face; grips desks 24-49 mm thick
    - Clamp checks at a hand-tight 400 N: spine SF 2.7, lower arm 2.6
    - Prints 22/23 (clamps, on their side), 24 (pads); BOM P29/P30; assembly
    step; FeatureScript stand parts appended at the end
    - 84 parts, 0 collisions for both tip sets; GripperV2 updated (SHA-256
    2247dc24e097f38b, 84 instances, 21/21 features OK, e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
    [BOM.csv]
2026-10-25 Motor choice, homing by closing, encoder bench-test script, ABS stand
    - Motor: 42x42x40 NEMA 17 with integrated 300 mm Tr8x8 screw and brass
    nut, 1.5 A, about 0.4 N.m (e.g. DiGiYes B0CG5WQK3T, Amazon US); matches
    the design assumptions. Screw cut length now given from the pilot face
    (76.5 mm), review item 17
    - Homing closes into a stop (pads meet / carriage on the motor wall), so
    the reaction goes through the collar, 608 and printed lip instead of the
    motor bearing, whose axial rating budget motors don't publish
    - rev7/firmware/as5600_bench_test.py: Pico MicroPython test that reads
    the AS5600 status, AGC, magnitude and angle with the magnet in a 608
    - Stand parts stay ABS (Anurag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
    [BOM.csv]
2026-10-25 Motor: YEJMKJ N17-Y42-39-SG240 (Amazon B0FHHWXJLV), now in the cart
    - The first pick (DiGiYes B0CG5WQK3T) is unavailable; the YEJMKJ motor
    (42x42x38.7 mm, Tr8x8 240 mm with brass flange nut, 0.44 N.m, 1.7 A,
    2.2 ohm, 3.1 mH, rotor about 65 g cm2) fits the design unchanged
    - analysis.py / structural.py use its torque, current and rotor inertia:
    driver 0.70 A, grip >= 26.0 N per jaw, stall 75-107 N, in-use min SF 2.0
    - BOM P1 and the handoff decision updated (added to cart, not ordered)
    [BOM.csv]
2026-10-25 Amazon cart: the rest of the BOM (31 items, $311.61, not ordered)
    docs/AMAZON_CART_2026-10-24.md lists every item with its ASIN, pack size and
    price, plus five items to check with the fablab first (TPU, resistors,
    capacitors, epoxy). BOM: 4 x 40 hardened dowels (Amazon US has no 4 x 36;
    checked clear of the controller board), 304 stainless shoulder screws (shear
    SF 46 -> 12), M5 x 14 for the column end.
    [BOM.csv]
2026-10-25 Cost cut: lean parts list, 20 items $188.90 (was $311.61)
    Pico on USB (no buck/diode), no switch, alarm, extension, strap, felt or
    header sockets; printed controller spacers (25_ControllerSpacer.stl);
    cut M3 screws as block locating pins; cheaper equivalents elsewhere.
    [BOM.csv]
2026-10-25 Battery: USB-C power bank + 12 V PD trigger instead of LiPo + charger
    Keeps battery power, cuts the battery parts from $50.96 to $6.99 if an
    existing 20 W / 12 V-capable bank is used. Lean list now 17 items $144.93.
    Divider now reads motor power present (12 V -> 2.55 V).
    [BOM.csv]
2026-10-25 Portable power: 9 V PD trigger, 7805 feeds the Pico, demo mode without a laptop
    9 V works with any PD power bank and USB-C laptop/phone chargers of 18 W+.
    Speed capped at 300 rpm on 9 V (40 mm/s, 0.8 s stroke); grip unchanged.
    [BOM.csv]
2026-10-25 Keep the TMC2209 and Pico socketed (female headers, $5.99)
    [BOM.csv]
2026-10-25 Build and test guide + Pico bench tool (tests, homing, grip, BOOTSEL demo)
    docs/BUILD_AND_TEST_GUIDE.md: parts check, fit tests, magnet test, printing,
    controller board with power checks, VREF 0.99 V, assembly, powered tests,
    stand, demo mode, troubleshooting. firmware/bench.py (checked against a
    simulated Pico, including inverted DIR and encoder) and optional main.py.
    Report: stale battery/standoff text fixed, 26 inserts.
    [BOM.csv]
2026-10-25 Model shows what is being bought; GripperV2 updated (90 parts)
    YEJMKJ motor body 38.7 mm, 4 x 40 dowels (4 mm proud of the cover), headless
    M3 locating pins, printed controller spacers + 4 M3x16, 7805 instead of the
    buck, new 100 uF capacitor and USB-C PD trigger board, power bank on the desk
    instead of the LiPo. 90 parts, 0 collisions over 41 poses for both tip sets.
    Onshape: Feature Studio e7a058480f88bf76, existing part ids unchanged, 6 new
    instances in the frame group, all volumes within 0.7 mm3, slider verified.
    Also fixes the dowel height (4 mm, not 4.5) in the docs.
    [BOM.csv]
2026-10-26 Rev 7.2 finishing pass: limit case passes, fillets, electronics cover; Onshape standard screws and official Pico
    - Open hard stop 66 -> 60.5 mm (just past the 60 mm firmware cap): F1/F2 finger
    bores with pad-edge twist now pass the 200 N limit case (SF 1.0, was 0.6); new
    F1 twist row; screw cut 73.0 mm; bench.py gap table updated (sim test passes)
    - Fillets in the desk clamps' inside corners (R3/R6, base notched to match),
    stepped fillet at the stand column socket, 0.4 mm elephant's-foot relief on
    the carriage tongue's bed side
    - Printed electronics cover (26_ElectronicsCover) with cable notches, BOOTSEL
    window and driver vents; 2 M3x8 into 2 more cover-top inserts (28 total)
    - Pic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
    [BOM.csv]
2026-10-26 Compact controller (cover 38% smaller) and flush dowels
    - Protoboard cut to 48 x 60 on 4 mm spacers; 7805 lying flat, 100 uF standing
    beside the driver; Pico-end mounting screws between the Pico socket rows;
    M3 x 10 instead of x 16. Electronics cover 54 x 66 x 26.2 mm (envelope
    151 -> 93 cm3)
    - Dowels: 4 x 40 cut to 38.5 mm, pressed through the base, flush with its
    underside and the cover top; press fit 9 mm (base hole SF 4.7 -> 6.8)
    - 95 parts, 0 collisions over 41 poses, both tip sets
    - Onshape updated: 97 bodies within 0.7 mm3, moved standard screws re-inserted,
    Pico re-placed, 97 instances, none broken, 21/21 features OK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
    [BOM.csv]
2026-10-30 Print files named after the Onshape GripperV2 parts
    STL names are now part number + Onshape part name (05 BellCrank Lower U, 12 Finger L,
    18 Pad TPU U+L, ...): A files are the U side, B_mirrored files the L side. Docs, BOM,
    print_parts.json and the export/doc scripts use the new names; make_docs, guide_render
    and export no longer parse the old underscore pattern.
    [BOM.csv]
2026-10-30 Print files: Onshape part name + print quantity, no part numbers
    STL names are now e.g. 'BellCrank Upper U+L x2', 'Pad TPU U+L x4', 'Finger U x1'.
    Docs, BOM, print_parts.json and the export/doc scripts use the new names; scripts that
    picked parts by number now pick them by name, and print_parts.json keeps export order.
    [BOM.csv]
2026-10-30 Rev 6 record: Onshape part names + print quantity in docs and scripts
    [BOM.csv]
2026-11-06 ROS 2 workspace for the rev 7 gripper, exported from GripperV2
    Restores ros2_ws (from the old repo's history) and moves it to rev 7:
    - onshape/: export of the GripperV2 "Robot export" tab, version
    robot-export-v2. Zero pose is the 60.5 mm open stop; joint limits
    updated for 0..60.5 mm (carriage 0..26.5 mm).
    - onshape_render/: same version with every part as its own fixed link
    and colour, for recordings; urdf/lead_screw_gripper_render.urdf.xacro.
    - linkage.py: GAP_MAX 60.5 mm, THETA_EXPORT at the open stop;
    jaw_node default stroke 0.7 s; tests updated, plus a joint-limit test
    (43 pass).
    - view_gripper.launch.py takes model:= and rviz:=; rviz/record.rviz for
    screen recordings with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
    [608zz_bearing.stl, adapter_iso9409_50.stl, as5600_encoder_board.stl, base.stl, base_link_visual.stl, bell_crank_L_link_visual.stl, bell_crank_U_link_visual.stl, bell_crank_lower_u.stl]
2026-11-06 Rev 7 docs: fix the printed-volume grouping
    make_docs.py counted the stand as files 20_ and 21_ only, so the desk
    clamps and clamp pads (22_-24_) and the 13b/13c fit-test coupons ended up
    in the "gripper" total. Gripper with the narrow set is 362 cm³ (was 497),
    ~207 g at typical infill (was ~284 g); bench stand 505 cm³ (was 395).
    DESIGN_REPORT.md row updated to what the fixed script produces.
    [make_docs.py]
2026-11-13 Build guide: accuracy fixes from an independent check, plus an illustrated checklist version
    - Bushings go on in D10, after the cranks (they blocked the linkage in D3)
    - M3 button heads take a 2 mm key, not 2.5
    - Controller board hole positions and electronics-cover notch side corrected
    - TPU clamp pads added to the print list and the stand steps
    - Homing troubleshooting matches the firmware; 'Homed' alone is not a pass
    - Print file names match the stl folder
    - New rev 7 step pictures and docs/BUILD_AND_TEST_GUIDE.html
2026-11-13 ROS 2 hardware interface, Pico ROS firmware, fake Pico; remove superseded files
    - Pico firmware for ROS: gripper_core.py (protocol and motion state machine, no hardware code),
    hal_pico.py (TMC2209, AS5600, PIO steps, ported from bench.py), ros_main.py (USB serial loop).
    - lead_screw_gripper_hardware: ros2_control SystemInterface plugin, one jaw_gap joint, serial to the Pico.
    - lead_screw_gripper_bringup: description with ros2_control, parallel-gripper action controller config,
    hardware.launch.py, gap_to_joints node, fake_pico (real firmware logic + simulated gripper).
    - Tests: 42 firmware unit tests, end-to-end launch test against the fake Pico, wrong-port test.
    Nothing has run on the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
    [BOM.csv, hardware_controllers.yaml, lead_screw_gripper_hardware.urdf.xacro]
2026-11-13 Build guide: point the parts list at BOM.csv
2026-11-13 README for outside readers; fix broken references and personal workflow notes
    - Front page: images, status table (predicted / simulated / measured), how it works,
    origin of the linkage design and how the project was built.
    - Test, xacro and README pointed at ROS2_HANDOFF.md, which is not in the repo: now the
    design report's jaw-gap table. Fixed old clone paths.
    - Build guide and bench test: instructions no longer depend on a chat assistant.
    [lead_screw_gripper.urdf.xacro]
2026-11-13 Remove notes on CAD tooling from the README and design records
